nsternie/live_telemetry/board_design/Flight_computer_LT/FlightCompTop.png

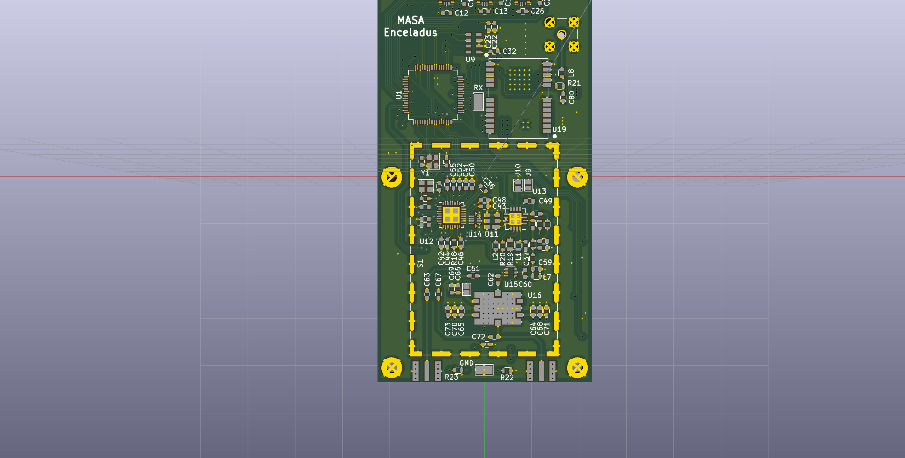
board_design/Flight_computer_LT/FlightCompTop.png
