nsternie/live_telemetry/README.md

# live_telmetry
Home for all data related to the live telemetry project. Firmware, Gui, and board designs,
