nsternie/live_telemetry/scripts/data/2018_03_03_21-58-39/0_plots.pdf

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

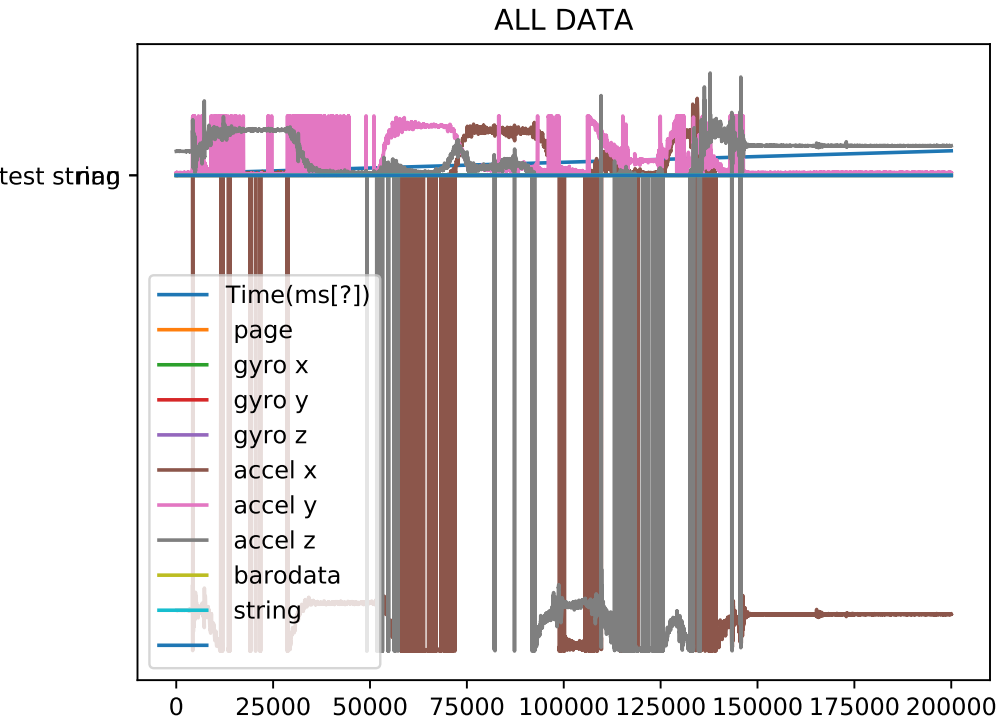
[picture p2: page 1]

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

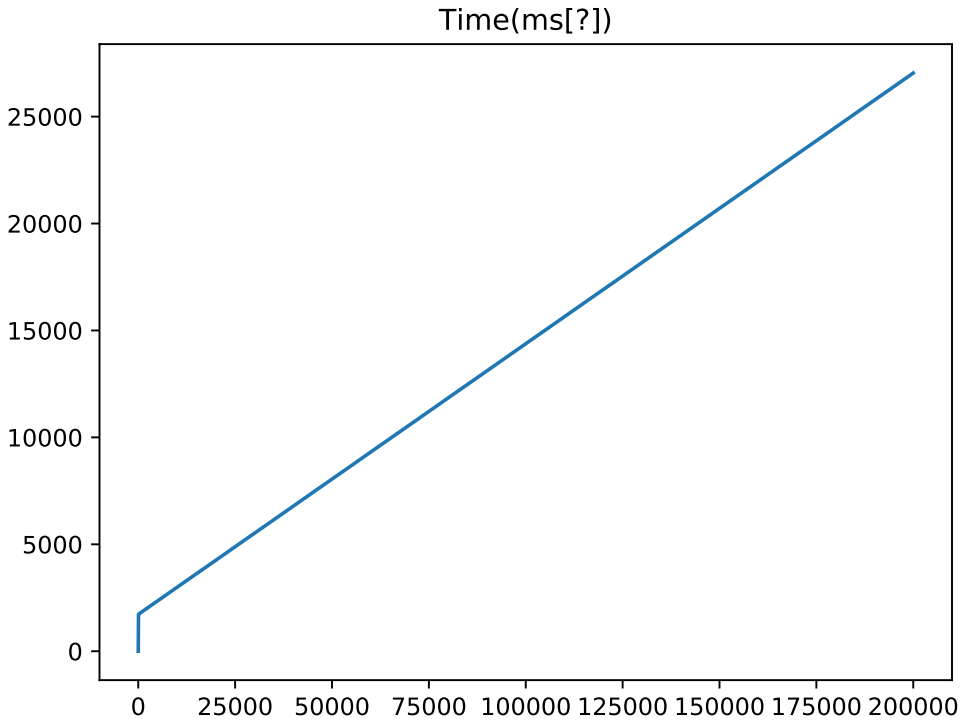
[picture p3: page 2]

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

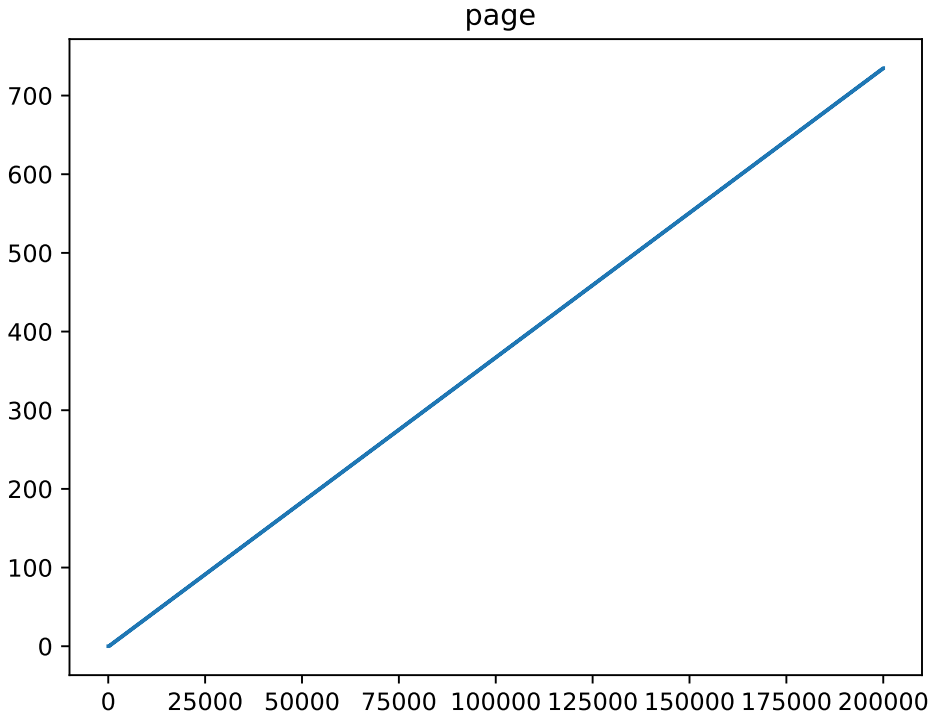
[picture p4: page 3]

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

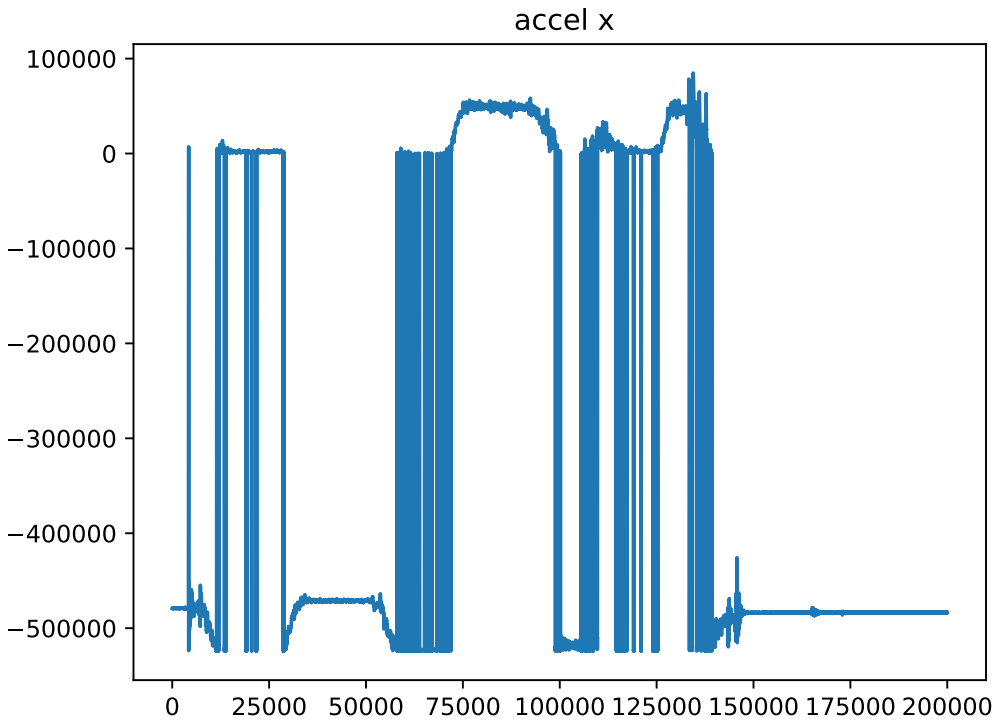
[picture p5: page 7]

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

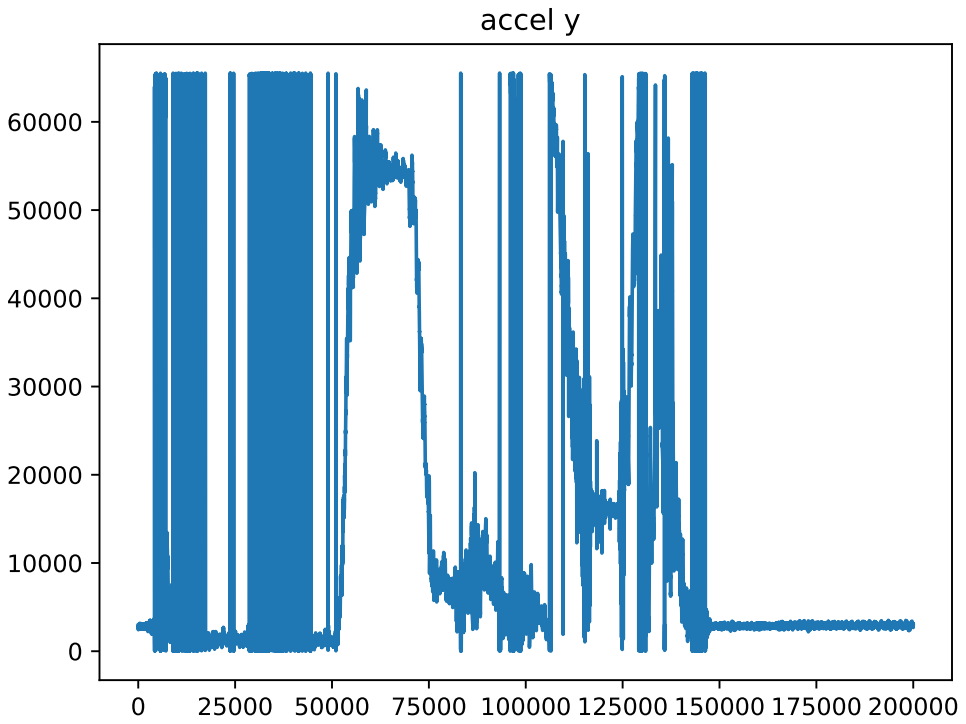
[picture p6: page 8]

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

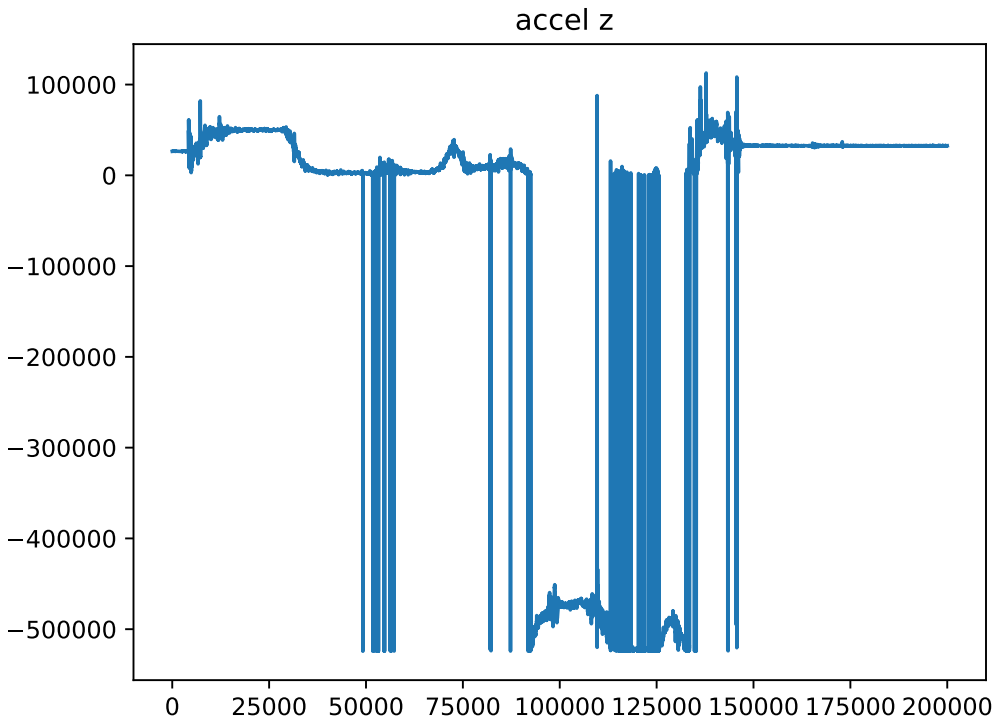
[picture p7: page 9]

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
