nsternie/live_telemetry/scripts/data/2018_03_03_22-02-40/0_plots.pdf

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

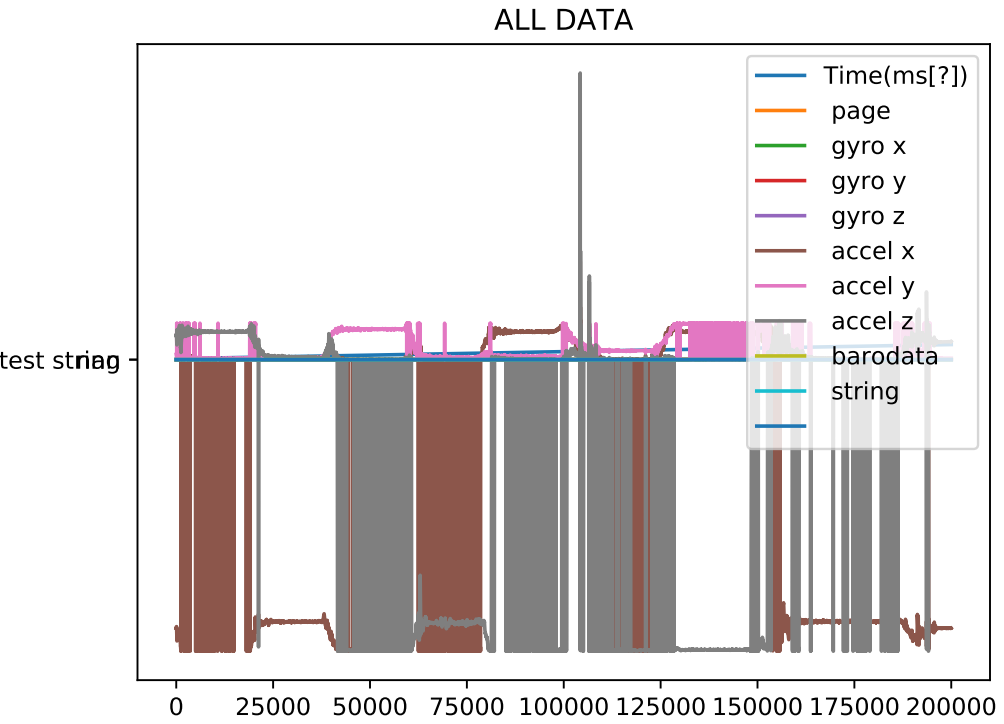
[picture p8: page 1]

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

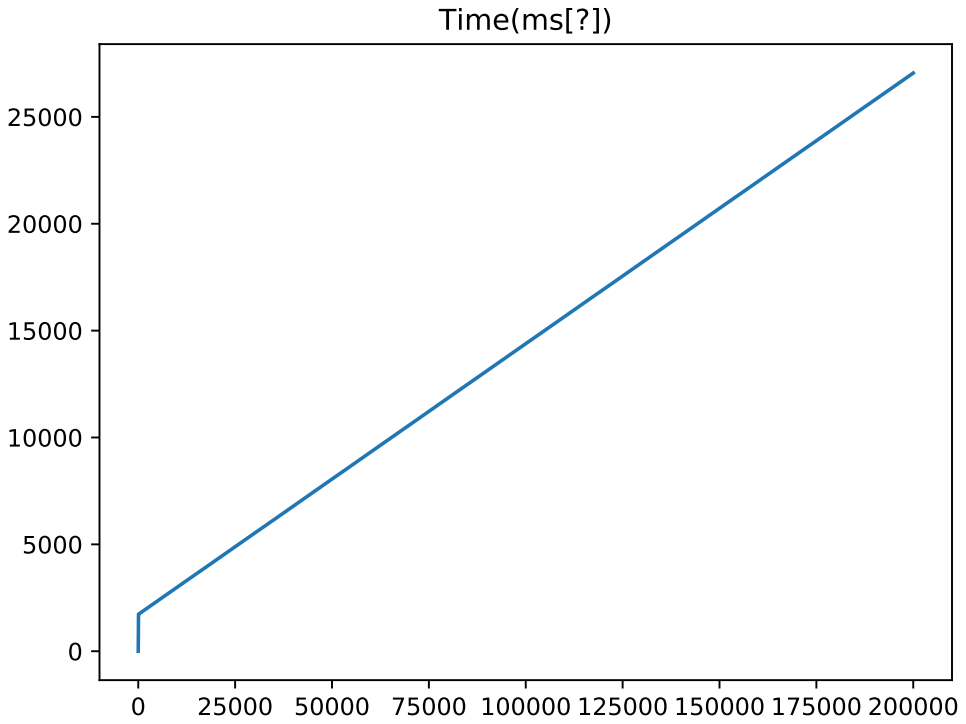
[picture p9: page 2]

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

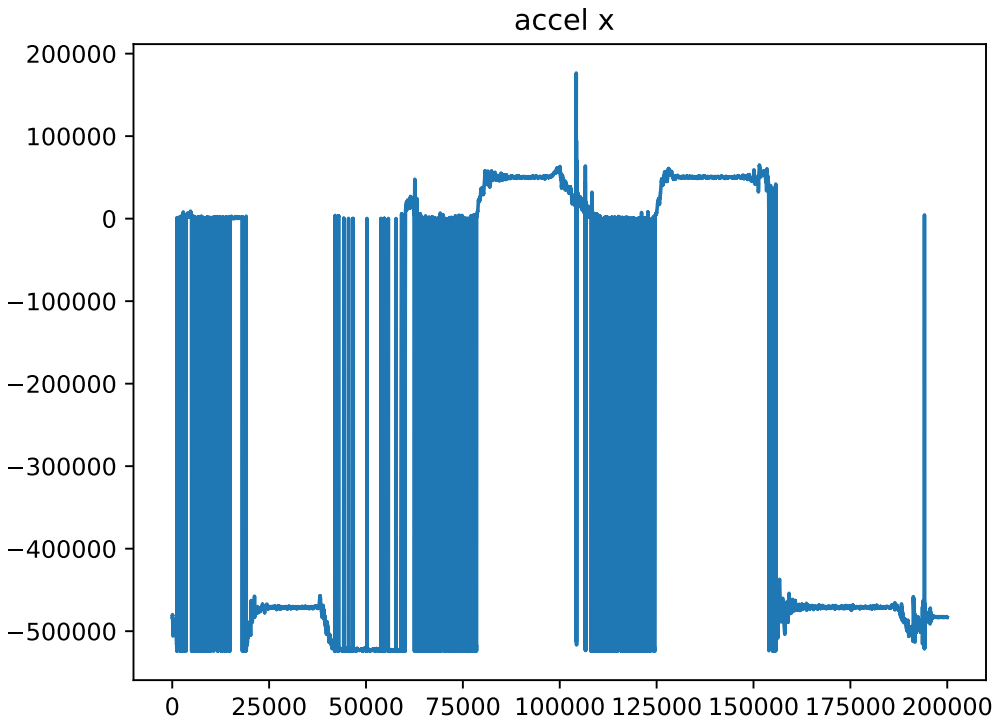
[picture p10: page 7]

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

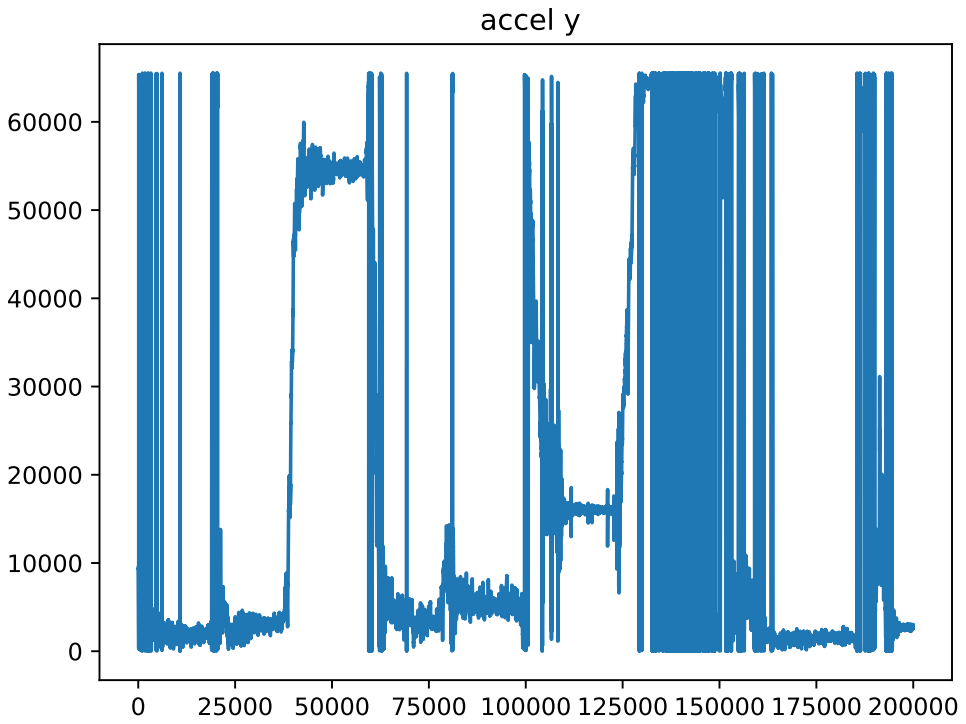
[picture p11: page 8]

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

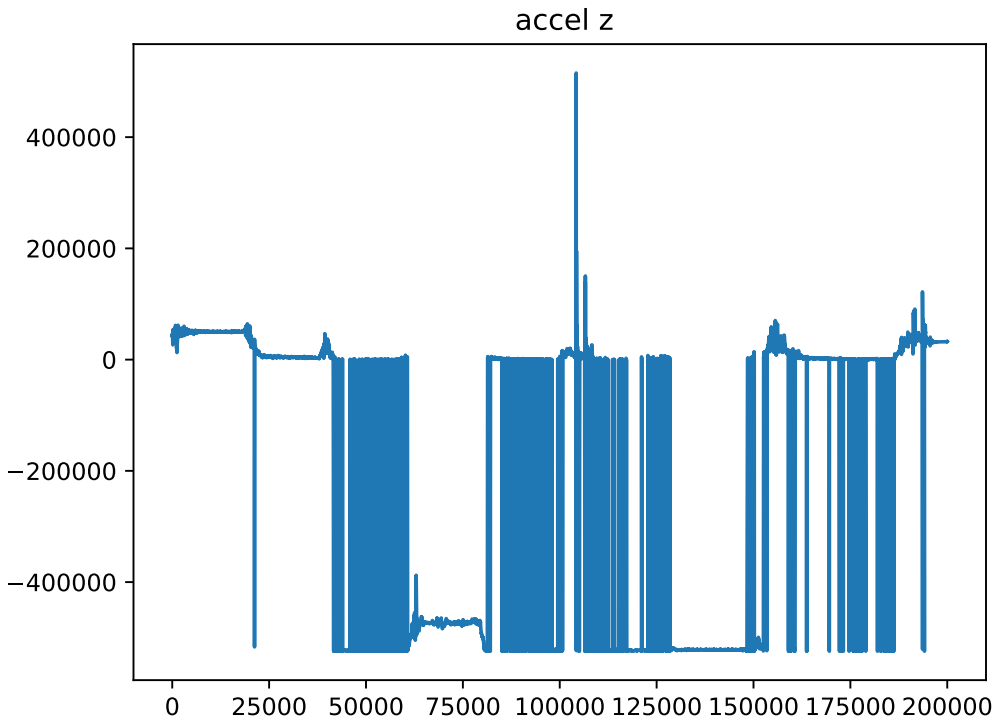
[picture p12: page 9]

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
