nsternie/live_telemetry/scripts/data/2018_03_03_22-16-44/0_plots.pdf

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

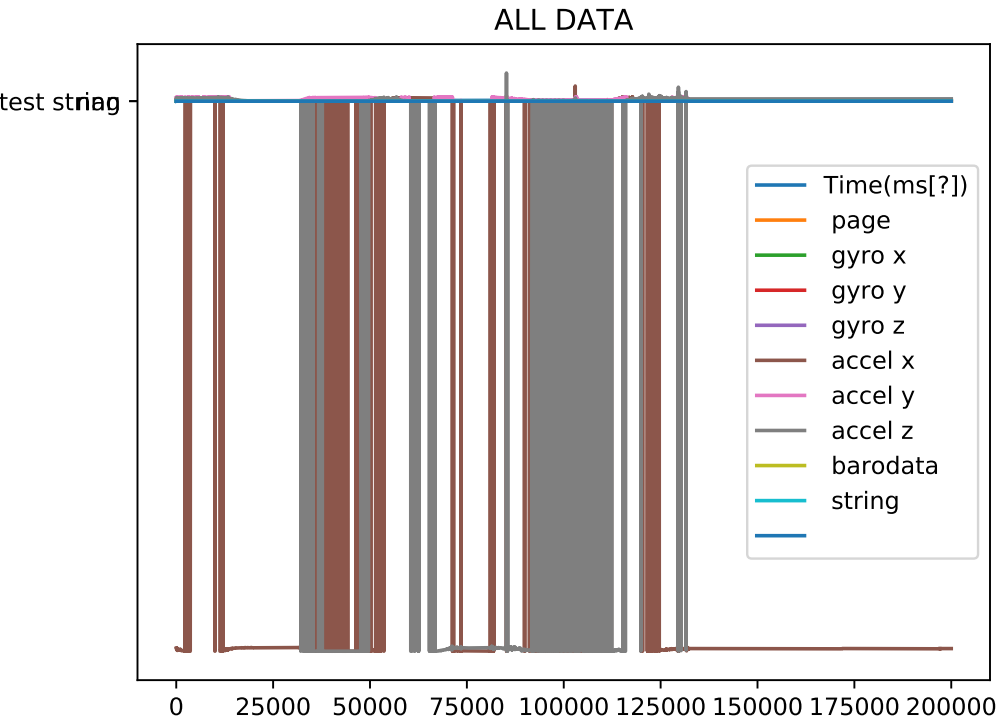
[picture p13: page 1]

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

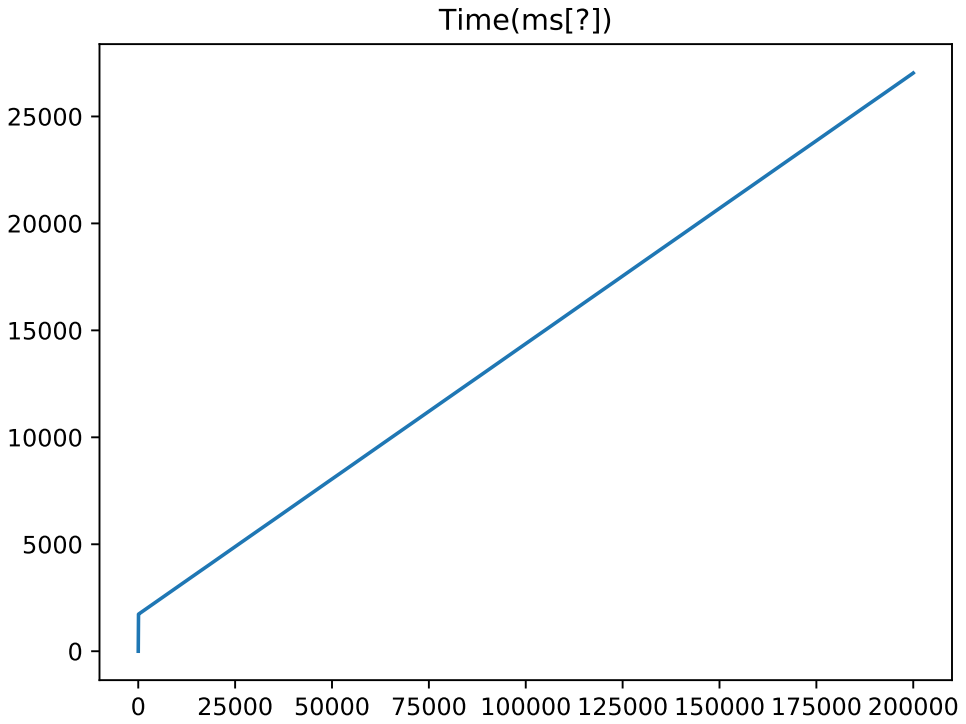
[picture p14: page 2]

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

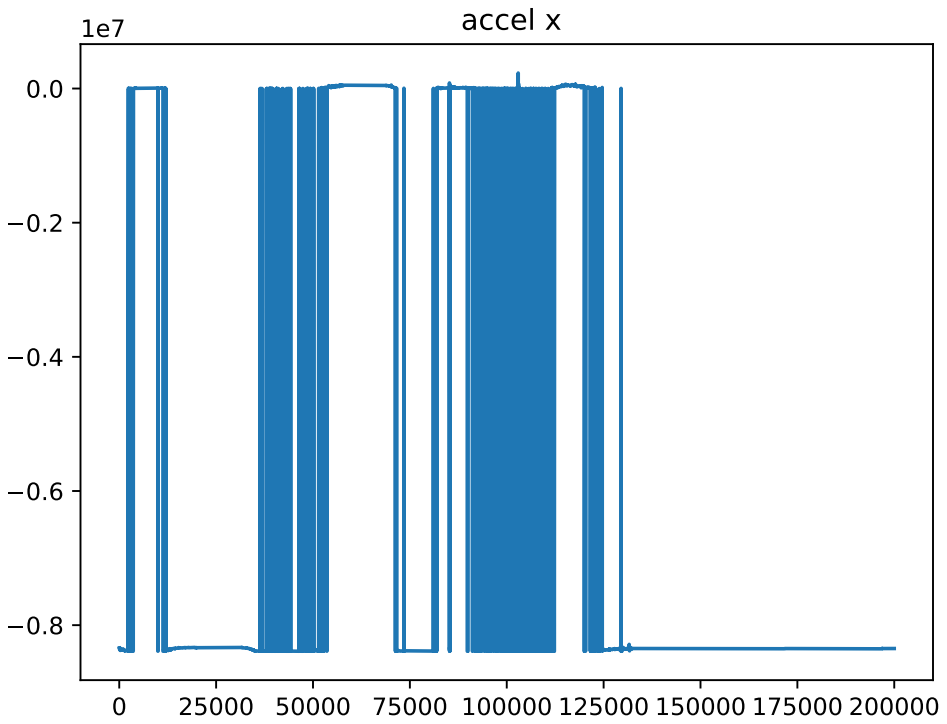
[picture p15: page 7]

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

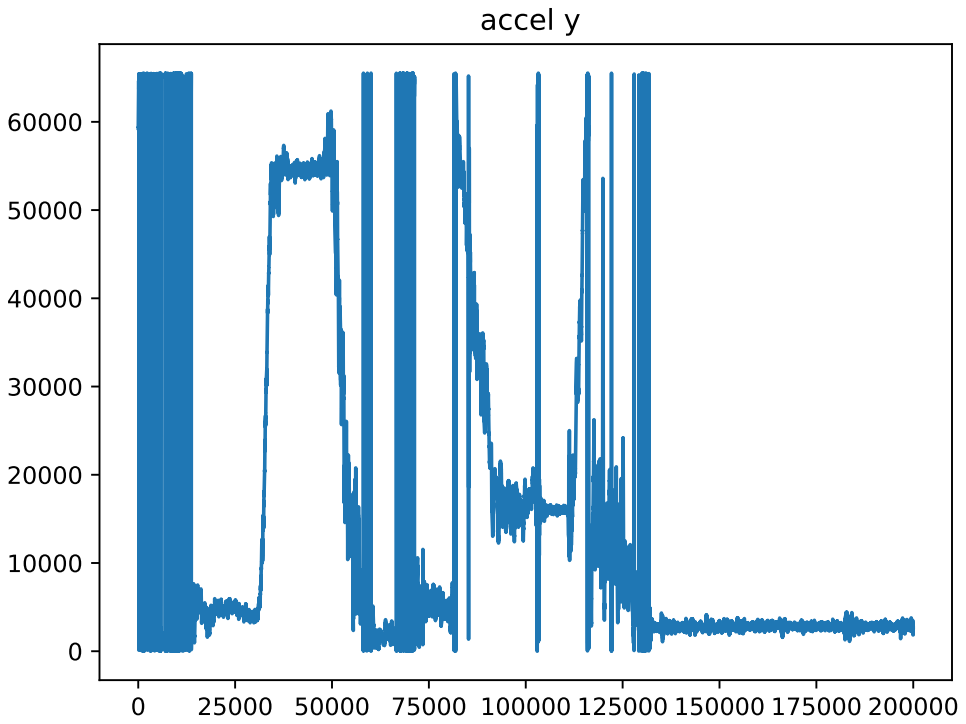
[picture p16: page 8]

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

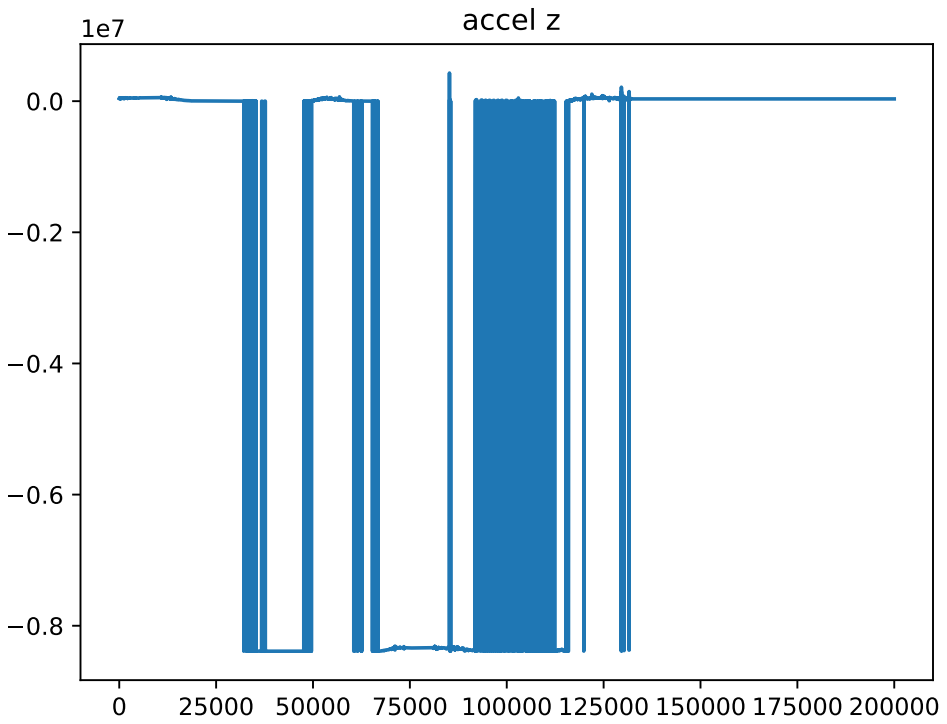
[picture p17: page 9]

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
