nsternie/live_telemetry/scripts/data/2018_03_03_22-34-58/0_plots.pdf

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

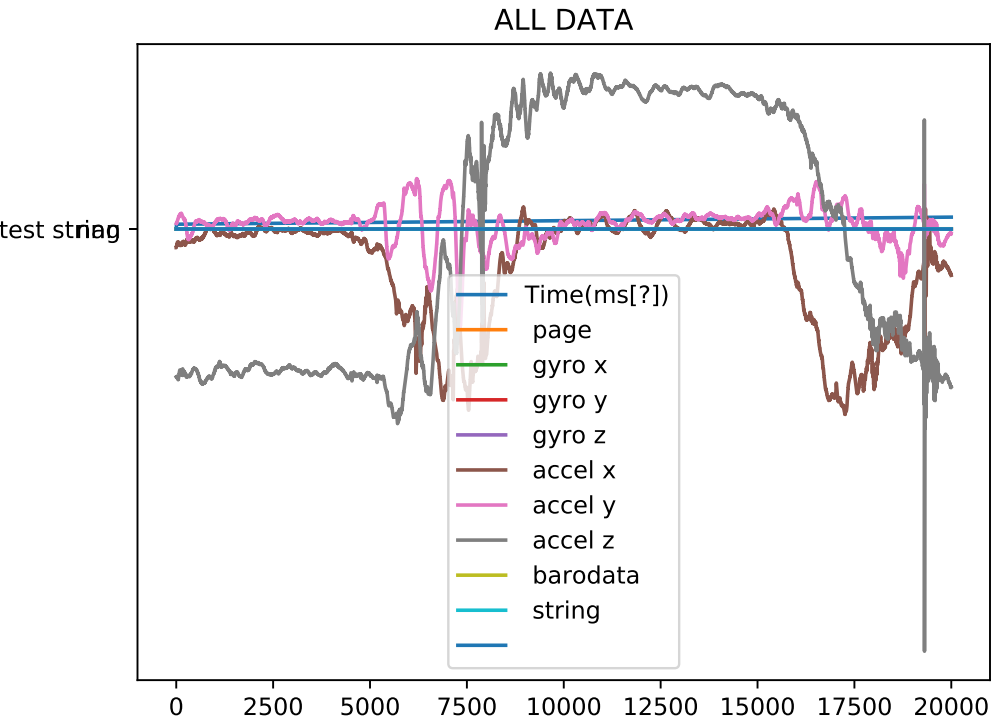
[picture p18: page 1]

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

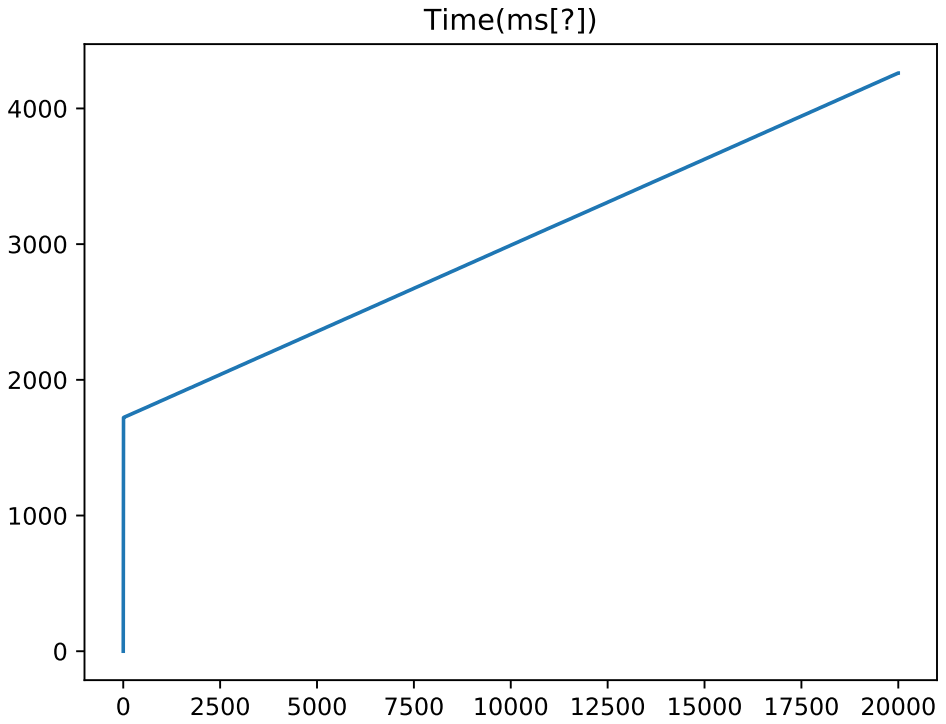
[picture p19: page 2]

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

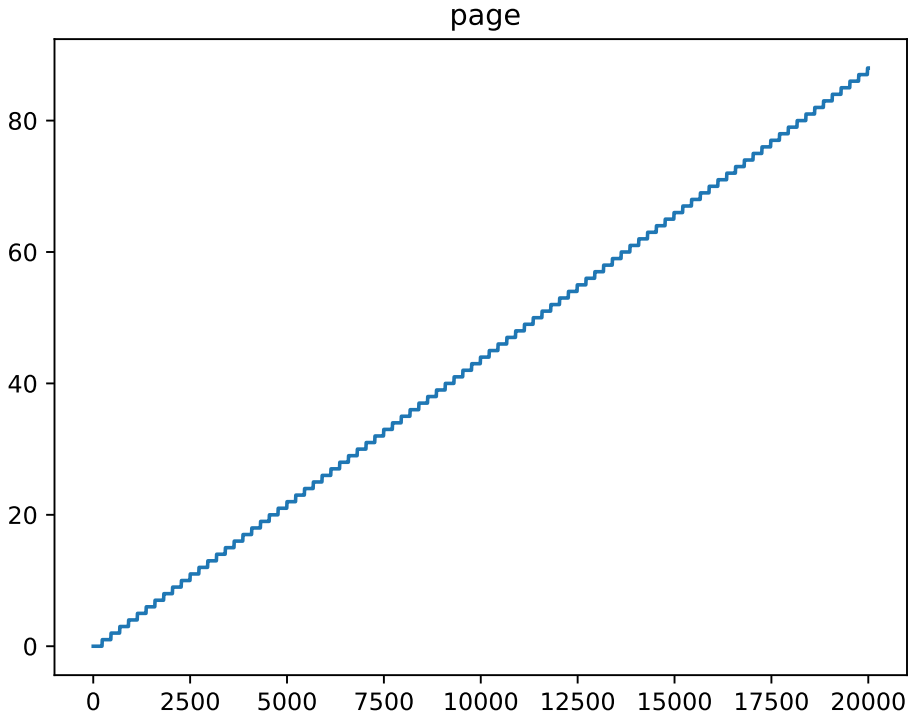
[picture p20: page 3]

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

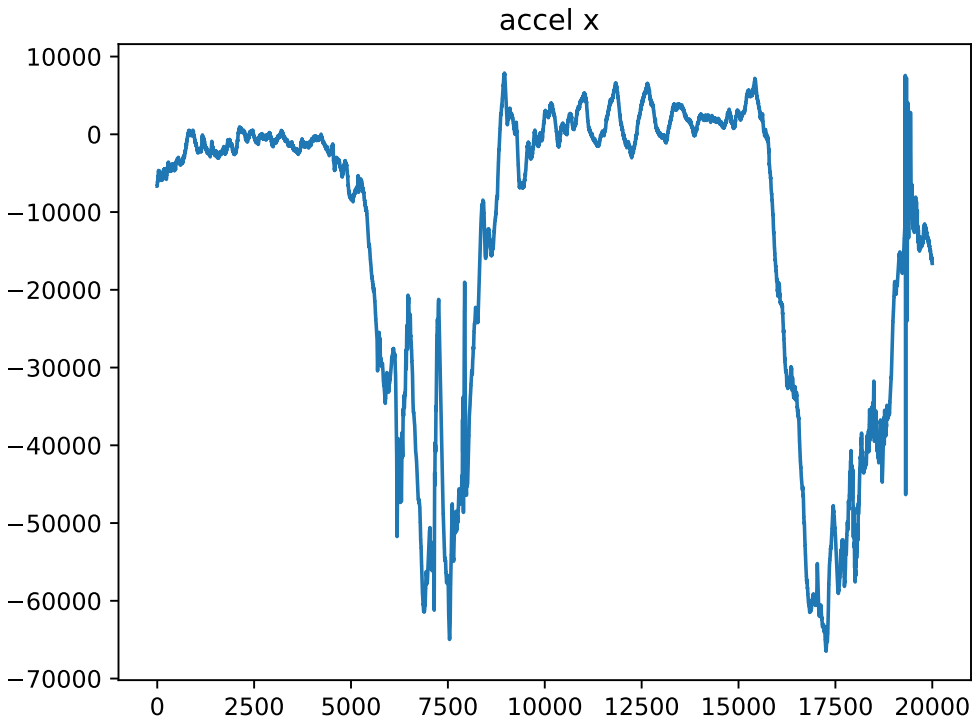
[picture p21: page 7]

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

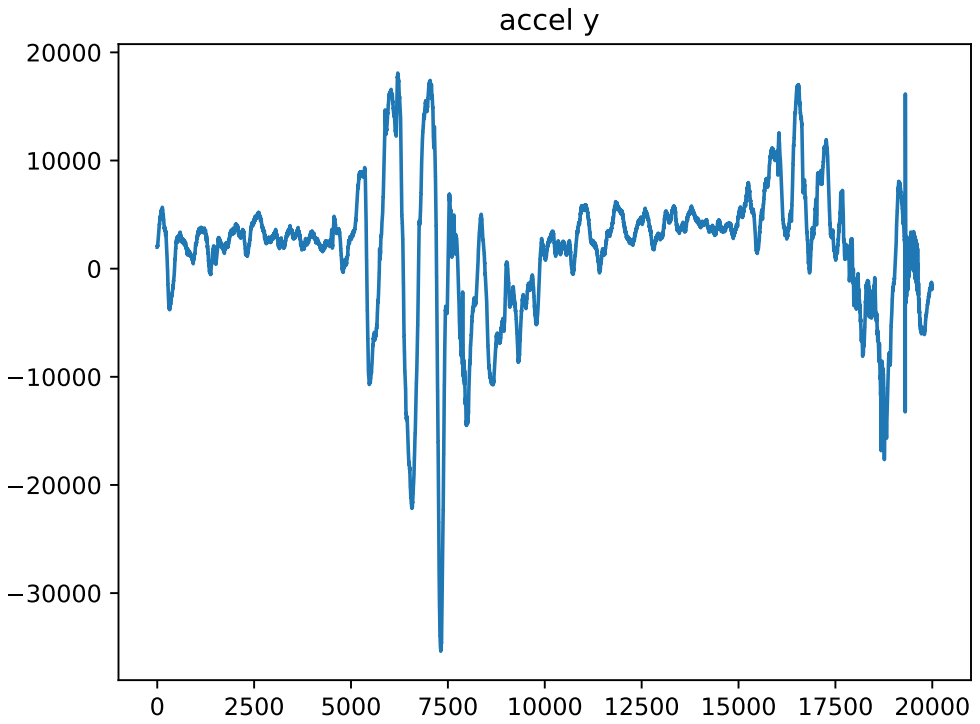
[picture p22: page 8]

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

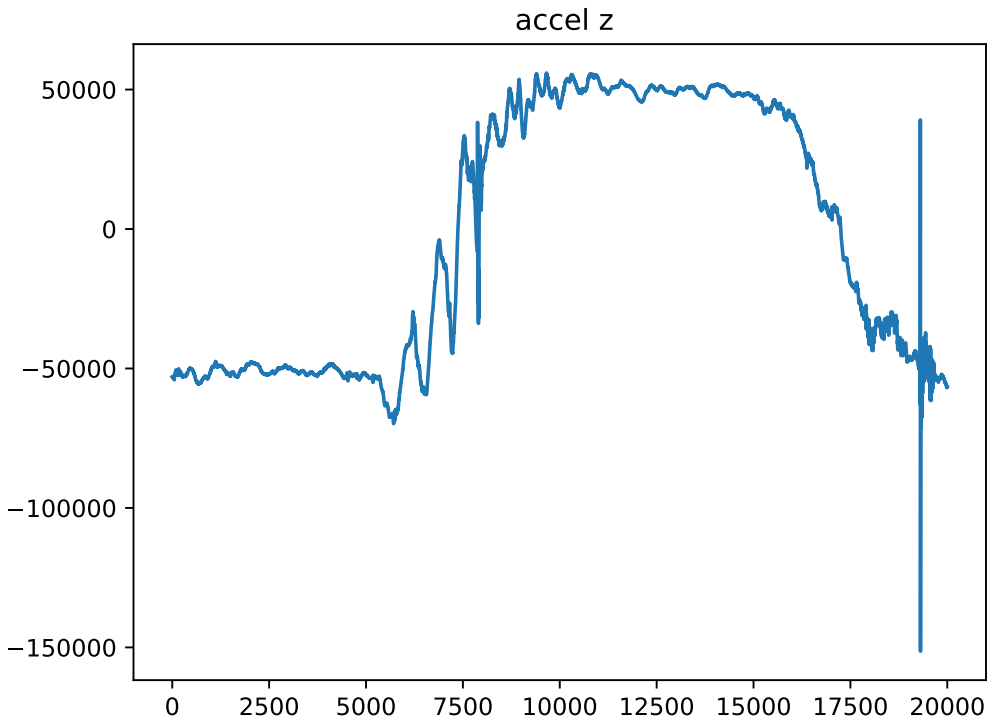
[picture p23: page 9]

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
