nsternie/live_telemetry/board_design/Flight_computer_LT/Flight_computer_LT.kicad_pcb

## KiCad design board_design/Flight_computer_LT/Flight_computer_LT.kicad_pcb (2018-03-17)

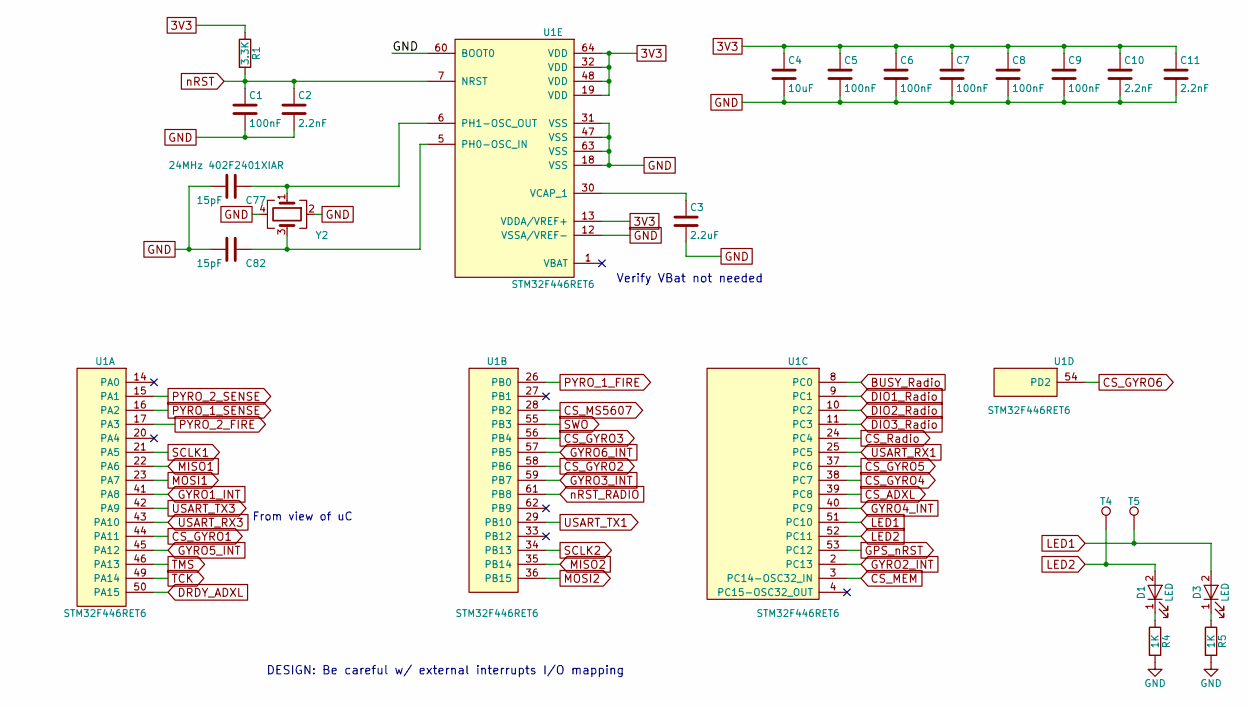
[picture p24: schematic Microcontroller.sch, part in row 1, column 2]

Parts:
C1, C5, C6, C7, C8, C9: 100nF; C_0603
C2, C10, C11: 2.2nF; C_0603
C3: 2.2uF; C_0603
C4: 10uF; C_0603
C77, C82: 15pF; C_0603
D1, D3: LED; LED_0603
R1: 3.3K; R_0603
R4, R5: 1K; R_0603
T4, T5: TP; 0603_TP
U1: STM32F446RET6; LQFP-64_10x10mm_Pitch0.5mm
Y2: 24MHz 402F2401XIAR; Crystal_SMD_2520-4pin_2.5x2.0mm

Connections:
3V3: C4.1, C5.1, C6.1, C7.1, C8.1, C9.1, C10.1, C11.1, R1.1, U1.13 (VDDA/VREF+), U1.19 (VDD), U1.32 (VDD), U1.48 (VDD), U1.64 (VDD); also elsewhere on the board
BUSY_Radio: U1.8 (PC0); also elsewhere on the board
CS_ADXL: U1.39 (PC8); also elsewhere on the board
CS_GYRO1: U1.44 (PA11); also elsewhere on the board
CS_GYRO2: U1.58 (PB6); also elsewhere on the board
CS_GYRO3: U1.56 (PB4); also elsewhere on the board
CS_GYRO4: U1.38 (PC7); also elsewhere on the board
CS_GYRO5: U1.37 (PC6); also elsewhere on the board
CS_GYRO6: U1.54 (PD2); also elsewhere on the board
CS_MEM: U1.3 (PC14-OSC32_IN); also elsewhere on the board
CS_MS5607: U1.28 (PB2); also elsewhere on the board
CS_Radio: U1.24 (PC4); also elsewhere on the board
DIO1_Radio: U1.9 (PC1); also elsewhere on the board
DIO2_Radio: U1.10 (PC2); also elsewhere on the board
DIO3_Radio: U1.11 (PC3); also elsewhere on the board
DRDY_ADXL: U1.50 (PA15); also elsewhere on the board
GND: C1.2, C2.2, C3.2, C4.2, C5.2, C6.2, C7.2, C8.2, C9.2, C10.2, C11.2, C77.2, C82.2, R4.2, R5.2, U1.12 (VSSA/VREF-), U1.18 (VSS), U1.31 (VSS), U1.47 (VSS), U1.60 (BOOT0), U1.63 (VSS), Y2.2, Y2.4; also elsewhere on the board
GPS_nRST: U1.53 (PC12); also elsewhere on the board
GYRO1_INT: U1.41 (PA8); also elsewhere on the board
GYRO2_INT: U1.2 (PC13); also elsewhere on the board
GYRO3_INT: U1.59 (PB7); also elsewhere on the board
GYRO4_INT: U1.40 (PC9); also elsewhere on the board
GYRO5_INT: U1.45 (PA12); also elsewhere on the board
GYRO6_INT: U1.57 (PB5); also elsewhere on the board
LED1: D3.2 (A), T5.1, U1.51 (PC10)
LED2: D1.2 (A), T4.1, U1.52 (PC11)
MISO1: U1.22 (PA6); also elsewhere on the board
MISO2: U1.35 (PB14); also elsewhere on the board
MOSI1: U1.23 (PA7); also elsewhere on the board
MOSI2: U1.36 (PB15); also elsewhere on the board
unnamed: C3.1, U1.30 (VCAP_1)
unnamed: C77.1, U1.6 (PH1-OSC_OUT), Y2.1
unnamed: C82.1, U1.5 (PH0-OSC_IN), Y2.3
unnamed: D1.1 (K), R4.1
unnamed: D3.1 (K), R5.1
PYRO_1_FIRE: U1.26 (PB0); also elsewhere on the board
PYRO_1_SENSE: U1.16 (PA2); also elsewhere on the board
PYRO_2_FIRE: U1.17 (PA3); also elsewhere on the board
PYRO_2_SENSE: U1.15 (PA1); also elsewhere on the board
SCLK1: U1.21 (PA5); also elsewhere on the board
SCLK2: U1.34 (PB13); also elsewhere on the board
SWO: U1.55 (PB3); also elsewhere on the board
TCK: U1.49 (PA14); also elsewhere on the board
TMS: U1.46 (PA13); also elsewhere on the board
USART_RX1: U1.25 (PC5); also elsewhere on the board
USART_RX3: U1.43 (PA10); also elsewhere on the board
USART_TX1: U1.29 (PB10); also elsewhere on the board
USART_TX3: U1.42 (PA9); also elsewhere on the board
nRST: C1.1, C2.1, R1.2, U1.7 (NRST); also elsewhere on the board
nRST_RADIO: U1.61 (PB8); also elsewhere on the board

Notes on the sheet:
Verify VBat not needed
DESIGN: Be careful w/ external interrupts I/O mapping
From view of uC

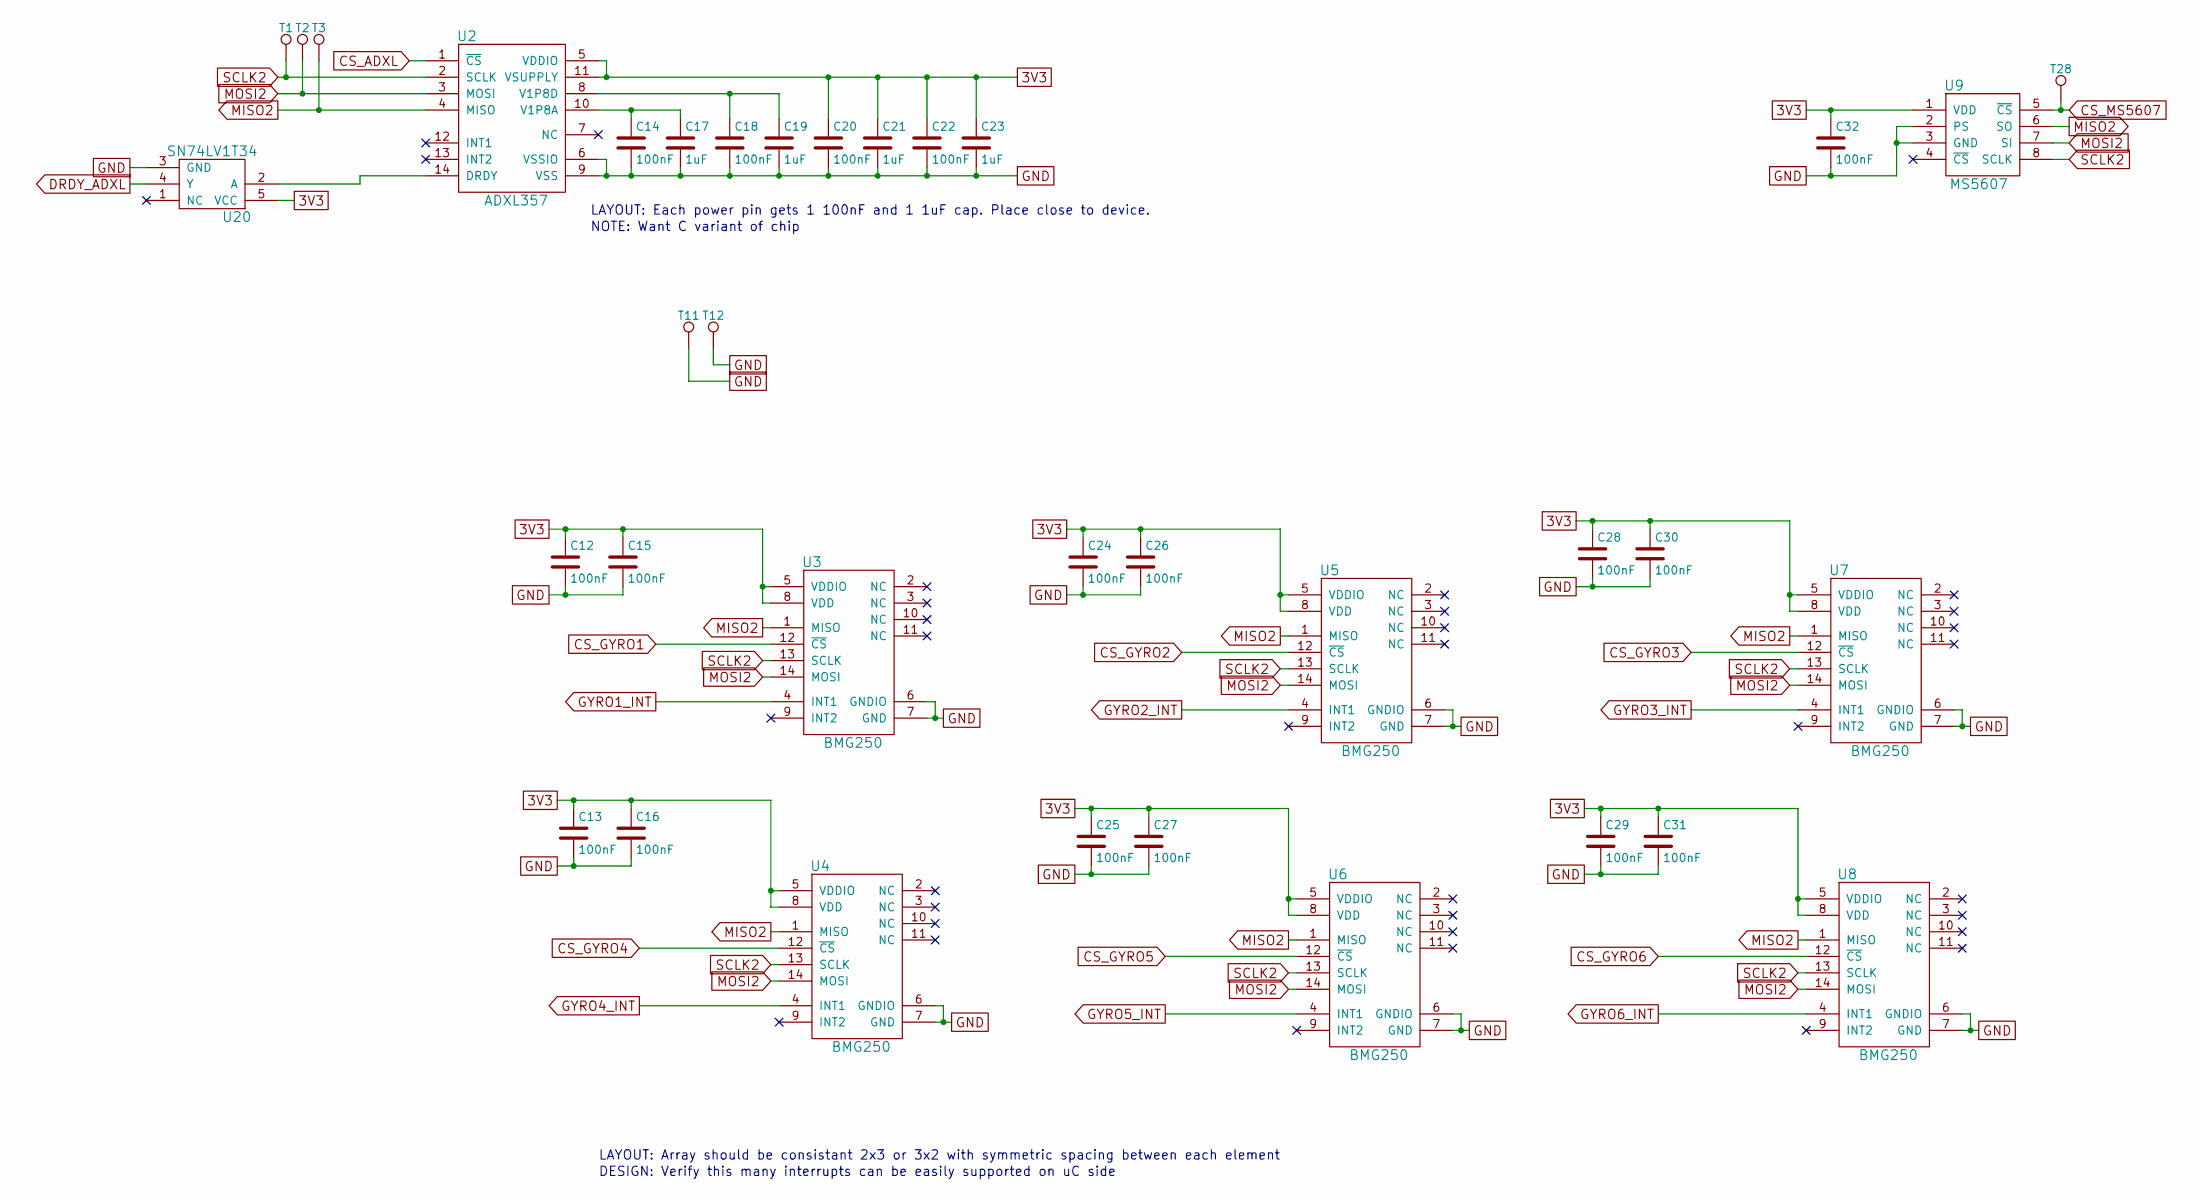
[picture p25: schematic Sensors.sch]

Parts:
C12, C13, C14, C15, C16, C18, C20, C22, C24, C25, C26, C27, C28, C29, C30, C31, C32: 100nF; C_0603
C17, C19, C21, C23: 1uF; C_0603
T1, T2, T3, T11, T12: TP; 0603_TP
T28: TEST_1P; PAD_TP_1mm
U2: ADXL357
U3, U4, U5, U6, U7, U8: BMG250; Bosch_LGA-14_3x2.5mm_Pitch0.5mm
U9: MS5607
U20: SN74LV1T34; SOT-23-5

Connections:
3V3: C12.1, C13.1, C15.1, C16.1, C20.1, C21.1, C22.1, C23.1, C24.1, C25.1, C26.1, C27.1, C28.1, C29.1, C30.1, C31.1, C32.1, U2.5 (VDDIO), U2.11 (VSUPPLY), U3.5 (VDDIO), U3.8 (VDD), U4.5 (VDDIO), U4.8 (VDD), U5.5 (VDDIO), U5.8 (VDD), U6.5 (VDDIO), U6.8 (VDD), U7.5 (VDDIO), U7.8 (VDD), U8.5 (VDDIO), U8.8 (VDD), U9.1 (VDD), U20.5 (VCC); also elsewhere on the board
CS_ADXL: U2.1 (~CS); also elsewhere on the board
CS_GYRO1: U3.12 (~CS); also elsewhere on the board
CS_GYRO2: U5.12 (~CS); also elsewhere on the board
CS_GYRO3: U7.12 (~CS); also elsewhere on the board
CS_GYRO4: U4.12 (~CS); also elsewhere on the board
CS_GYRO5: U6.12 (~CS); also elsewhere on the board
CS_GYRO6: U8.12 (~CS); also elsewhere on the board
CS_MS5607: T28.1, U9.5 (~CS); also elsewhere on the board
DRDY_ADXL: U20.4 (Y); also elsewhere on the board
GND: C12.2, C13.2, C14.2, C15.2, C16.2, C17.2, C18.2, C19.2, C20.2, C21.2, C22.2, C23.2, C24.2, C25.2, C26.2, C27.2, C28.2, C29.2, C30.2, C31.2, C32.2, T11.1, T12.1, U2.6 (VSSIO), U2.9 (VSS), U3.6 (GNDIO), U3.7 (GND), U4.6 (GNDIO), U4.7 (GND), U5.6 (GNDIO), U5.7 (GND), U6.6 (GNDIO), U6.7 (GND), U7.6 (GNDIO), U7.7 (GND), U8.6 (GNDIO), U8.7 (GND), U9.2 (PS), U9.3 (GND), U20.3 (GND); also elsewhere on the board
GYRO1_INT: U3.4 (INT1); also elsewhere on the board
GYRO2_INT: U5.4 (INT1); also elsewhere on the board
GYRO3_INT: U7.4 (INT1); also elsewhere on the board
GYRO4_INT: U4.4 (INT1); also elsewhere on the board
GYRO5_INT: U6.4 (INT1); also elsewhere on the board
GYRO6_INT: U8.4 (INT1); also elsewhere on the board
MISO2: T3.1, U2.4 (MISO), U3.1 (MISO), U4.1 (MISO), U5.1 (MISO), U6.1 (MISO), U7.1 (MISO), U8.1 (MISO), U9.6 (SO); also elsewhere on the board
MOSI2: T2.1, U2.3 (MOSI), U3.14 (MOSI), U4.14 (MOSI), U5.14 (MOSI), U6.14 (MOSI), U7.14 (MOSI), U8.14 (MOSI), U9.7 (SI); also elsewhere on the board
unnamed: C14.1, C17.1, U2.10 (V1P8A)
unnamed: C18.1, C19.1, U2.8 (V1P8D)
unnamed: U2.14 (DRDY), U20.2 (A)
SCLK2: T1.1, U2.2 (SCLK), U3.13 (SCLK), U4.13 (SCLK), U5.13 (SCLK), U6.13 (SCLK), U7.13 (SCLK), U8.13 (SCLK), U9.8 (SCLK); also elsewhere on the board

Notes on the sheet:
LAYOUT: Each power pin gets 1 100nF and 1 1uF cap. Place close to device.
LAYOUT: Array should be consistant 2x3 or 3x2 with symmetric spacing between each element
DESIGN: Verify this many interrupts can be easily supported on uC side
NOTE: Want C variant of chip

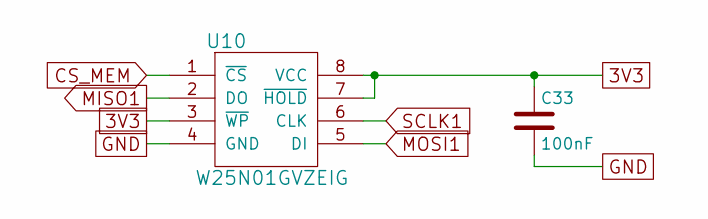
[picture p26: schematic Memory.sch]

Parts:
C33: 100nF; C_0603
U10: W25N01GVZEIG; 8-WSON_8x6

Connections:
3V3: C33.1, U10.3 (~WP), U10.7 (~HOLD), U10.8 (VCC); also elsewhere on the board
CS_MEM: U10.1 (~CS); also elsewhere on the board
GND: C33.2, U10.4 (GND); also elsewhere on the board
MISO1: U10.2 (DO); also elsewhere on the board
MOSI1: U10.5 (DI); also elsewhere on the board
SCLK1: U10.6 (CLK); also elsewhere on the board

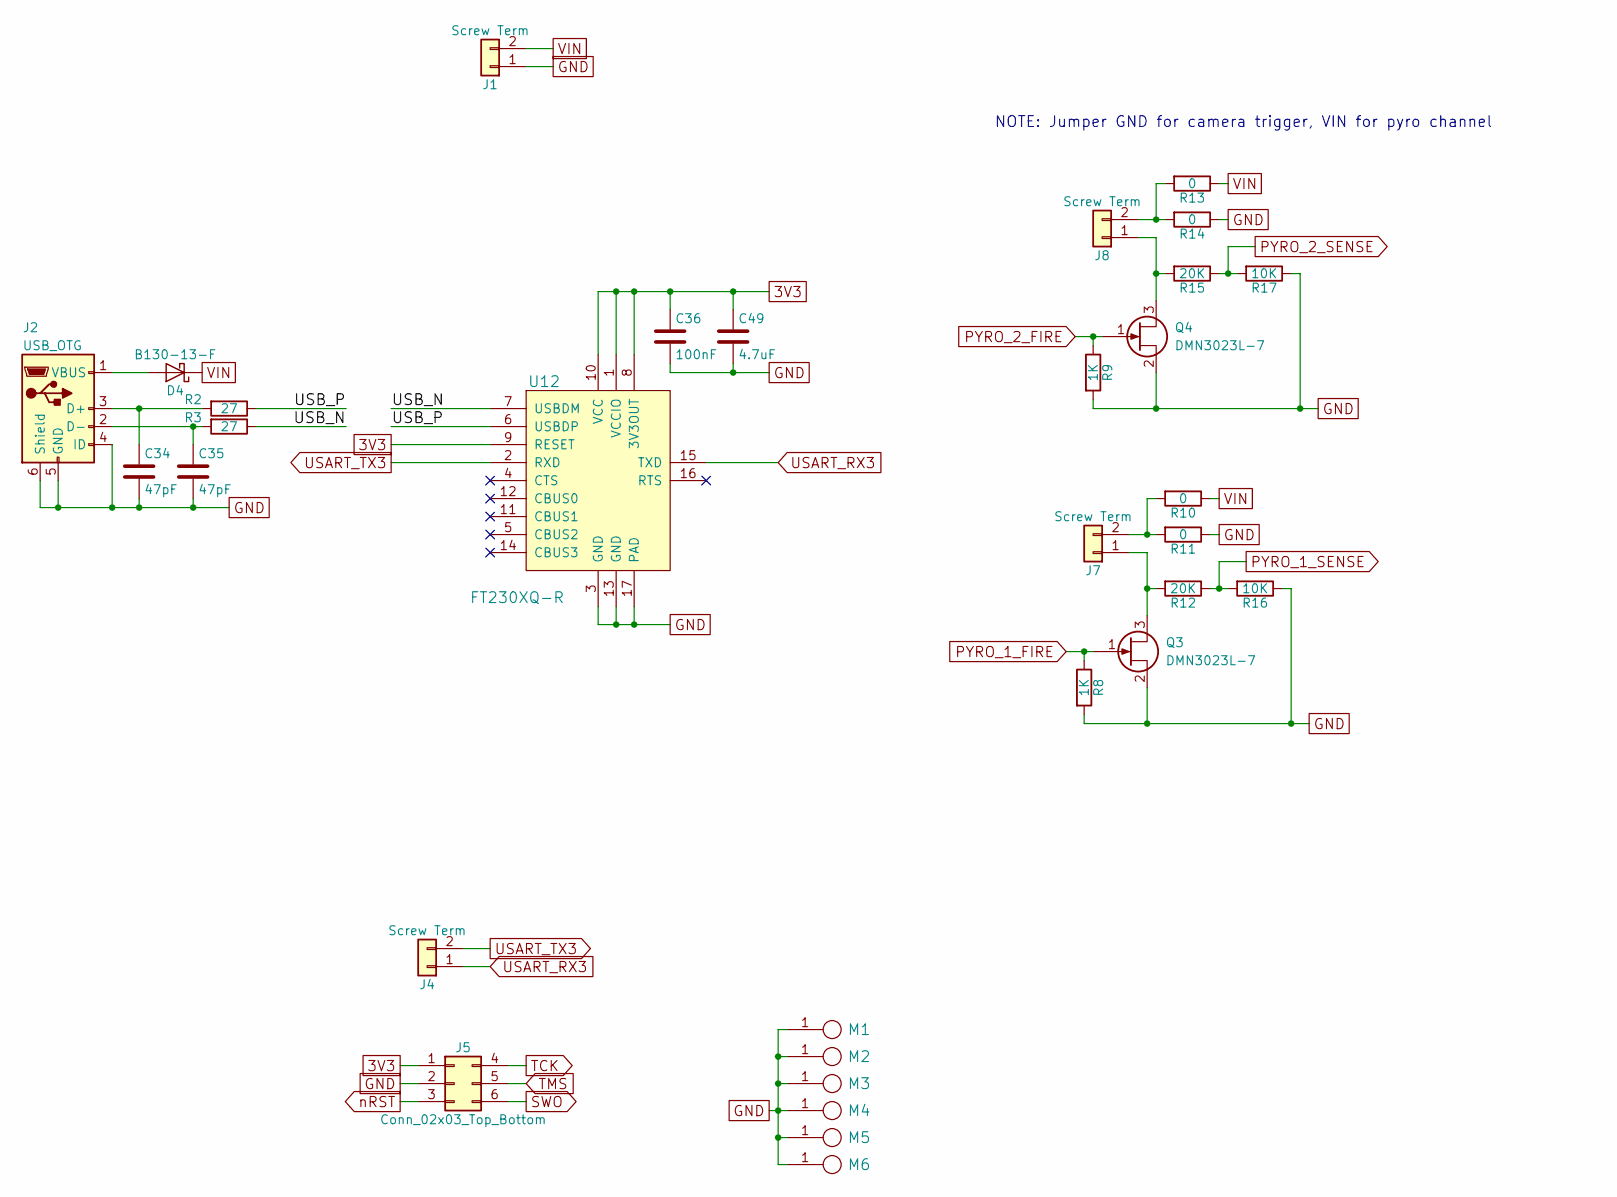
[picture p27: schematic Connectors.sch]

Parts:
C34, C35: 47pF; C_0603
C36: 100nF; C_0603
C49: 4.7uF; C_0603
D4: B130-13-F; D_SMA
J1, J4, J7, J8: Screw Term; TerminalBlock_bornier-2_P5.08mm
J2: USB_OTG; USB_Micro-B
J5: Conn_02x03_Top_Bottom; 2X6_SMA_HEADER_2.54mm
M1, M2, M3, M4, M5, M6: M2.5; MountingHole_2.2mm_M2_Pad
Q3, Q4: DMN3023L-7; SOT-23
R2, R3: 27; R_0603
R8, R9: 1K; R_0603
R10, R11, R13, R14: 0; R_0603
R12, R15: 20K; R_0603
R16, R17: 10K; R_0603
U12: FT230XQ-R; WQFN-16-1EP_4x4mm; MPN FT230XQ-R; Digi-Key_PN 768-1130-1-ND

Connections:
3V3: C36.1, C49.1, J5.1, U12.1 (VCCIO), U12.8 (3V3OUT), U12.9 (RESET), U12.10 (VCC); also elsewhere on the board
/Connectors/USB_N: R3.1, U12.7 (USBDM)
/Connectors/USB_P: R2.1, U12.6 (USBDP)
GND: C34.2, C35.2, C36.2, C49.2, J1.1, J2.4 (ID), J2.5 (GND), J2.6 (Shield), J5.2, M1.1, M2.1, M3.1, M4.1, M5.1, M6.1, Q3.2 (S), Q4.2 (S), R8.2, R9.2, R11.1, R14.1, R16.1, R17.1, U12.3 (GND), U12.13 (GND), U12.17 (PAD); also elsewhere on the board
unnamed: C34.1, J2.3 (D+), R2.2
unnamed: C35.1, J2.2 (D-), R3.2
unnamed: D4.2 (A), J2.1 (VBUS)
unnamed: J7.1, Q3.3 (D), R12.2
unnamed: J7.2, R10.2, R11.2
unnamed: J8.1, Q4.3 (D), R15.2
unnamed: J8.2, R13.2, R14.2
PYRO_1_FIRE: Q3.1 (G), R8.1; also elsewhere on the board
PYRO_1_SENSE: R12.1, R16.2; also elsewhere on the board
PYRO_2_FIRE: Q4.1 (G), R9.1; also elsewhere on the board
PYRO_2_SENSE: R15.1, R17.2; also elsewhere on the board
SWO: J5.6; also elsewhere on the board
TCK: J5.4; also elsewhere on the board
TMS: J5.5; also elsewhere on the board
USART_RX3: J4.1, U12.15 (TXD); also elsewhere on the board
USART_TX3: J4.2, U12.2 (RXD); also elsewhere on the board
VIN: D4.1 (K), J1.2, R10.1, R13.1; also elsewhere on the board
nRST: J5.3; also elsewhere on the board

Notes on the sheet:
NOTE: Jumper GND for camera trigger, VIN for pyro channel

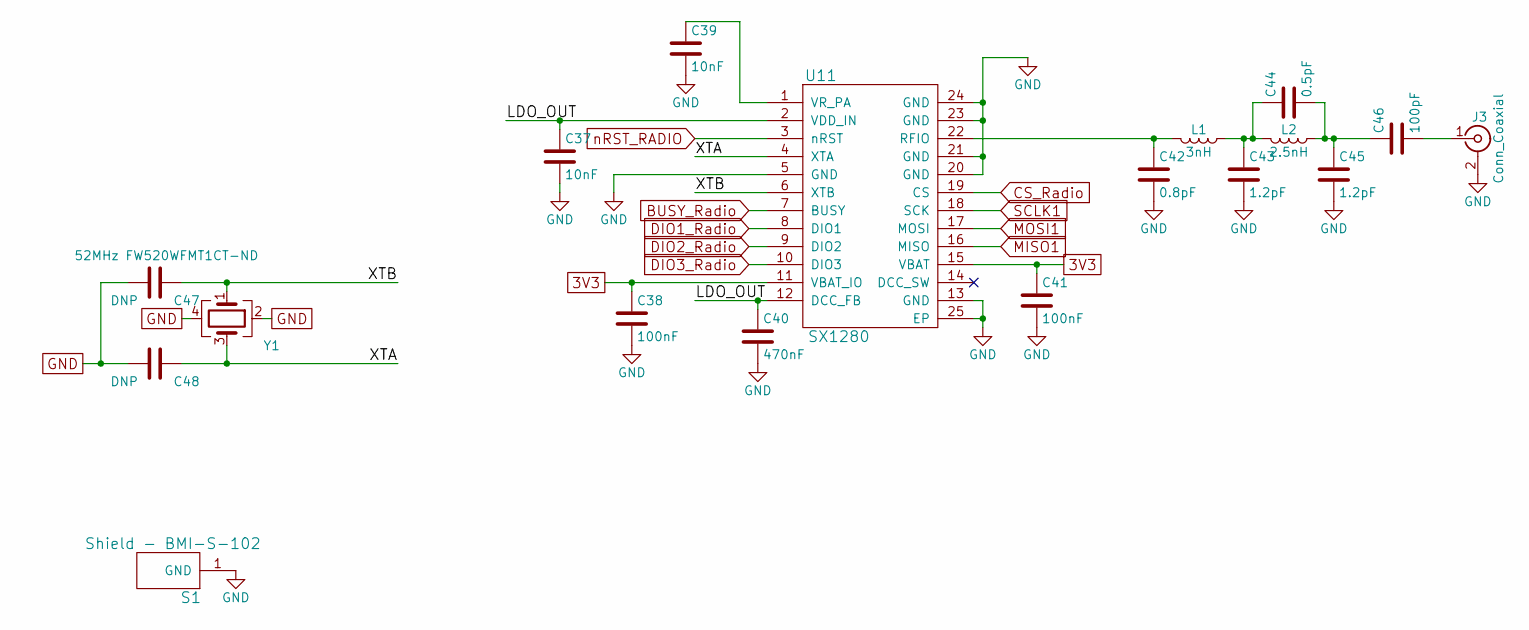
[picture p28: schematic Radio.sch]

Parts:
C37, C39: 10nF; 0603
C38, C41: 100nF; 0603
C40: 470nF; 0603
C42: 0.8pF; C_0402_NoSilk
C43, C45: 1.2pF; C_0402_NoSilk
C44: 0.5pF; C_0402_NoSilk
C46: 100pF; C_0402_NoSilk
C47, C48: DNP; C_0603
J3: Conn_Coaxial; EBAY_SMA
L1: 3nH; C_0402
L2: 2.5nH; C_0402
S1: Shield - BMI-S-102; Laird_Technologies_BMI-S-102_16.50x16.50mm
U11: SX1280; QFN-24-1EP_4x4mm_Pitch0.5mm
Y1: 52MHz FW520WFMT1CT-ND; Crystal_SMD_2016-4pin_2.0x1.6mm

Connections:
3V3: C38.1, C41.1, U11.11 (VBAT_IO), U11.15 (VBAT); also elsewhere on the board
/Radio/LDO_OUT: C37.1, C40.1, U11.2 (VDD_IN), U11.12 (DCC_FB)
/Radio/XTA: C48.1, U11.4 (XTA), Y1.3
/Radio/XTB: C47.1, U11.6 (XTB), Y1.1
BUSY_Radio: U11.7 (BUSY); also elsewhere on the board
CS_Radio: U11.19 (CS); also elsewhere on the board
DIO1_Radio: U11.8 (DIO1); also elsewhere on the board
DIO2_Radio: U11.9 (DIO2); also elsewhere on the board
DIO3_Radio: U11.10 (DIO3); also elsewhere on the board
GND: C37.2, C38.2, C39.2, C40.2, C41.2, C42.2, C43.2, C45.2, C47.2, C48.2, J3.2 (Ext), S1.1, U11.5 (GND), U11.13 (GND), U11.20 (GND), U11.21 (GND), U11.23 (GND), U11.24 (GND), U11.25 (EP), Y1.2, Y1.4; also elsewhere on the board
MISO1: U11.16 (MISO); also elsewhere on the board
MOSI1: U11.17 (MOSI); also elsewhere on the board
unnamed: C39.1, U11.1 (VR_PA)
unnamed: C42.1, L1.2, U11.22 (RFIO)
unnamed: C43.1, C44.1, L1.1, L2.2
unnamed: C44.2, C45.1, C46.1, L2.1
unnamed: C46.2, J3.1 (In)
SCLK1: U11.18 (SCK); also elsewhere on the board
nRST_RADIO: U11.3 (nRST); also elsewhere on the board

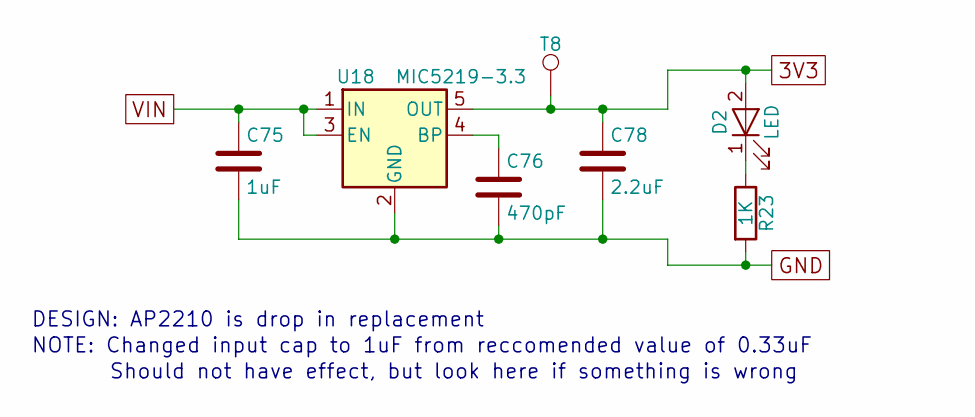
[picture p29: schematic Power.sch]

Parts:
C75: 1uF; C_0603
C76: 470pF; C_0603
C78: 2.2uF; C_0603
D2: LED; LED_0603
R23: 1K; R_0603
T8: TP; 0603_TP
U18: MIC5219-3.3; SOT-23-5

Connections:
3V3: C78.1, D2.2 (A), T8.1, U18.5 (OUT); also elsewhere on the board
GND: C75.2, C76.2, C78.2, R23.2, U18.2 (GND); also elsewhere on the board
unnamed: C76.1, U18.4 (BP)
unnamed: D2.1 (K), R23.1
VIN: C75.1, U18.1 (IN), U18.3 (EN); also elsewhere on the board

Notes on the sheet:
DESIGN: AP2210 is drop in replacement
NOTE: Changed input cap to 1uF from reccomended value of 0.33uF
Should not have effect, but look here if something is wrong

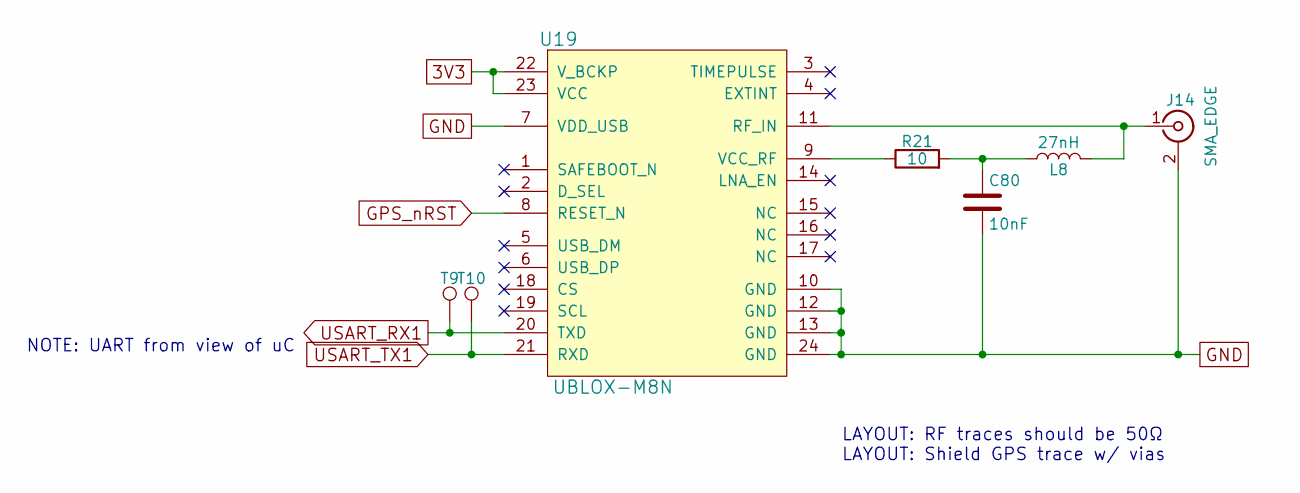
[picture p30: schematic GPS.sch]

Parts:
C80: 10nF; C_0603
J14: SMA_EDGE; EBAY_SMA
L8: 27nH; L_0603
R21: 10; R_0603
T9, T10: TP; 0603_TP
U19: UBLOX-M8N

Connections:
3V3: U19.22 (V_BCKP), U19.23 (VCC); also elsewhere on the board
GND: C80.2, J14.2 (Ext), U19.7 (VDD_USB), U19.10 (GND), U19.12 (GND), U19.13 (GND), U19.24 (GND); also elsewhere on the board
GPS_nRST: U19.8 (RESET_N); also elsewhere on the board
unnamed: C80.1, L8.1, R21.2
unnamed: J14.1 (In), L8.2, U19.11 (RF_IN)
unnamed: R21.1, U19.9 (VCC_RF)
USART_RX1: T9.1, U19.20 (TXD); also elsewhere on the board
USART_TX1: T10.1, U19.21 (RXD); also elsewhere on the board

Notes on the sheet:
NOTE: UART from view of uC
LAYOUT: RF traces should be 50Ω LAYOUT: Shield GPS trace w/ vias

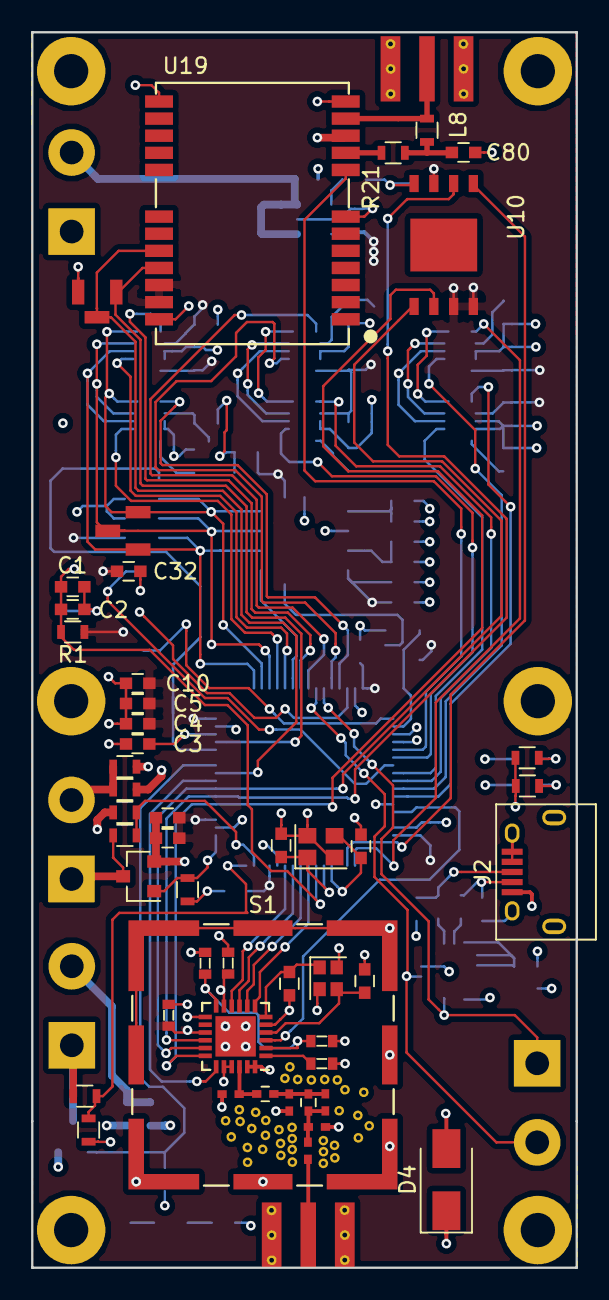
[picture p31: board Flight_computer_LT.kicad_pcb from above]

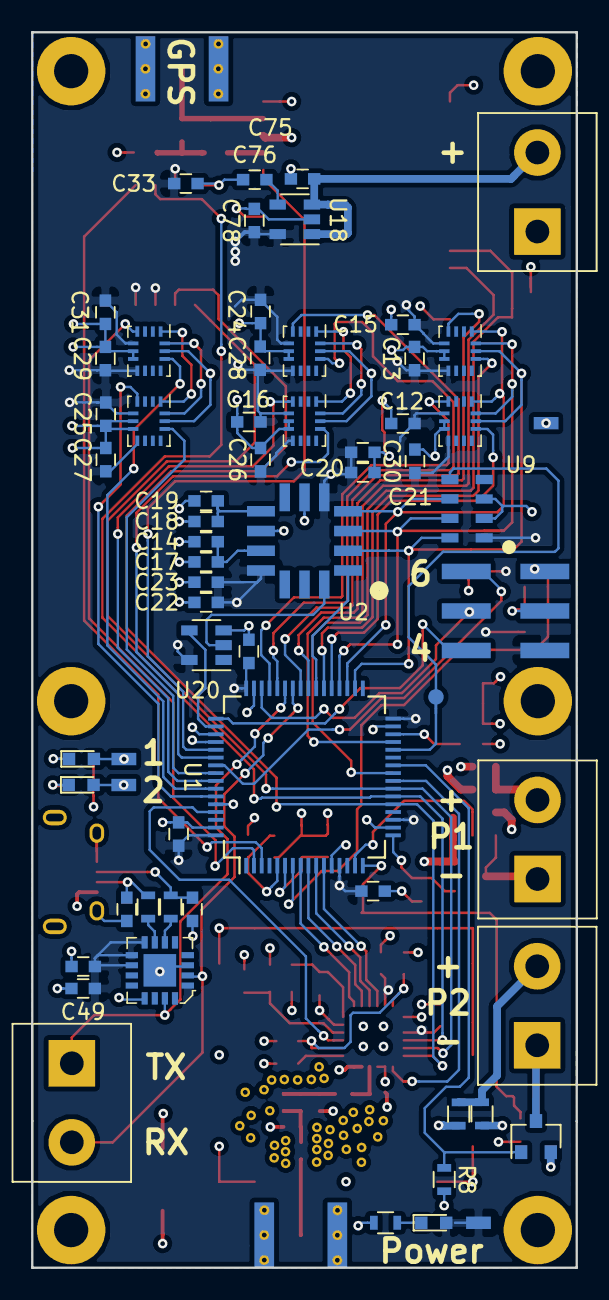
[picture p32: board Flight_computer_LT.kicad_pcb from below]

Board: 4 copper layers, 35.0 x 79.4 mm, 124 parts (63 on the bottom side), 76 nets.
