nsternie/live_telemetry/firmware/Atollic/Flight_Computer_Ground/Src/main.c

/**
  ******************************************************************************
  * File Name          : main.c
  * Description        : Main program body
  ******************************************************************************
  ** This notice applies to any and all portions of this file
  * that are not between comment pairs USER CODE BEGIN and
  * USER CODE END. Other portions of this file, whether 
  * inserted by the user or by software development tools
  * are owned by their respective copyright owners.
  *
  * COPYRIGHT(c) 2018 STMicroelectronics
  *
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
  ******************************************************************************
  */

/* Includes ------------------------------------------------------------------*/
#include "main.h"
#include "stm32f4xx_hal.h"

/* USER CODE BEGIN Includes */
#include "SX1280.h"
#include "flash.h"
#include "commandline.h"

/* USER CODE END Includes */

ADC_HandleTypeDef hadc1;

SPI_HandleTypeDef hspi1;
SPI_HandleTypeDef hspi2;

TIM_HandleTypeDef htim6;
TIM_HandleTypeDef htim7;
TIM_HandleTypeDef htim10;

UART_HandleTypeDef huart1;
UART_HandleTypeDef huart3;

/* USER CODE BEGIN PV */
volatile uint8_t radio_tim;
uint8_t uart1_in;
buffer uart1_buf;
uint8_t tx_pkt_cmd;
uint8_t radio_cmd;
uint8_t pkt_rdy;

/* USER CODE END PV */

void SystemClock_Config(void);
static void MX_GPIO_Init(void);
static void MX_ADC1_Init(void);
static void MX_SPI1_Init(void);
static void MX_SPI2_Init(void);
static void MX_TIM10_Init(void);
static void MX_USART1_UART_Init(void);
static void MX_USART3_UART_Init(void);
static void MX_TIM6_Init(void);
static void MX_TIM7_Init(void);

/* USER CODE BEGIN PFP */

/* USER CODE END PFP */

/* USER CODE BEGIN 0 */
#define LENGTH 23;
void stuff_telem(uint8_t *unstuffed, uint8_t *stuffed){
 const uint8_t *end = unstuffed + LENGTH;
 uint8_t *code_ptr = stuffed++;
 uint8_t code = 0x01;

 while (unstuffed < end){
   if (*unstuffed == '\n') {
     *code_ptr = code;
     code_ptr = stuffed++;
     code = 0x01;
   }
   else {
     *stuffed++ = *unstuffed;
     if (++code == 0xFF){
       *code_ptr = code;
       code_ptr = stuffed++;
       code = 0x01;
     }
   }
   unstuffed++;
 }
 *stuffed = '\n';

 *code_ptr = code;
 code_ptr = stuffed++;
 code = 0x01;
}
/* USER CODE END 0 */

int main(void)
{

  /* MCU Configuration----------------------------------------------------------*/

  /* Reset of all peripherals, Initializes the Flash interface and the Systick. */
  HAL_Init();

  /* Configure the system clock */
  SystemClock_Config();

  /* Initialize all configured peripherals */
  MX_GPIO_Init();
  MX_ADC1_Init();
  MX_SPI1_Init();
  MX_SPI2_Init();
  MX_TIM10_Init();
  MX_USART1_UART_Init();
  MX_USART3_UART_Init();
  MX_TIM6_Init();
  MX_TIM7_Init();

  /* USER CODE BEGIN 2 */
  //Local Vars
  uint8_t RXData[30] = {0};
  uint8_t TXData[30] = {0};
  uint8_t stuffed_pkt[25] = {0};
  uint8_t temp_pkt[5] = {0};
  uint8_t radio_tim_count = 0;
  pkt_rdy = 0;

  uint8_t line[160] = {0};
  snprintf(line, sizeof(line), "test\n\r");
  HAL_UART_Transmit(&huart1, line, strlen(line), 0xff);

  //Init CS pins to default state
  HAL_GPIO_WritePin(GYRO1_CS_GPIO_Port, GYRO1_CS_Pin, 1);
  HAL_GPIO_WritePin(GYRO2_CS_GPIO_Port, GYRO2_CS_Pin, 1);
  HAL_GPIO_WritePin(GYRO3_CS_GPIO_Port, GYRO3_CS_Pin, 1);
  HAL_GPIO_WritePin(GYRO4_CS_GPIO_Port, GYRO4_CS_Pin, 1);
  HAL_GPIO_WritePin(GYRO5_CS_GPIO_Port, GYRO5_CS_Pin, 1);
  HAL_GPIO_WritePin(GYRO6_CS_GPIO_Port, GYRO6_CS_Pin, 1);
  HAL_GPIO_WritePin(MS5607_CS_GPIO_Port, MS5607_CS_Pin, 1);
  HAL_GPIO_WritePin(ADXL_CS_GPIO_Port, ADXL_CS_Pin, 1);
  HAL_GPIO_WritePin(GPS_nRST_GPIO_Port, GPS_nRST_Pin, 1);
  HAL_GPIO_WritePin(MEM_CS_GPIO_Port, MEM_CS_Pin, 1);
  HAL_GPIO_WritePin(CS_Radio_GPIO_Port, CS_Radio_Pin, 1);

  //Cmd Interface Init
  buffer_init(&uart1_buf, UART_BUFFER_SIZE, 1);
  HAL_UART_Receive_IT(&huart1, &uart1_in, 1);

  //Init radio
  init_radio();

  HAL_Delay(100);
  radio_RXMode();

  //Start 100hz radio timer
  HAL_TIM_Base_Init(&htim7);
  HAL_TIM_Base_Start_IT(&htim7);



  while(1){
	  if(pkt_rdy){
		  //Receive packet if one comes in
		  radio_getPktStatus();

		  //Get RX Buffer Status
		  radio_getRXBufferStatus();

		  //Read buffer
		  radio_rxPacket(RXData);
		  uint8_t *pArray = &RXData[3];


		  RXData[25] = radio_getPktStatus();
		  if(RXData[3] == 0xFF){
			  //Do nothing if callsign packet
		  }
		  else{
			  stuff_telem(pArray, stuffed_pkt);
			  HAL_UART_Transmit(&huart1, stuffed_pkt, 25, 0xff);
		  }

		  //Clear IRQs
		  radio_clearInterrupt();
		  pkt_rdy = 0;

		  if(tx_pkt_cmd){
		  		  HAL_Delay(1); //Adjust to get timing right
		  		  uint8_t temp_pkt[30] = {0};
		  		  temp_pkt[2] = radio_cmd;
		  		  temp_pkt[3] = 0xFF - radio_cmd;
		  		  radio_txPacket(temp_pkt);
		  		  tx_pkt_cmd = 0;
		  		  HAL_Delay(100);
		  	  }
		  else{
			  radio_RXMode();
		  }
	  }

	  parse_buffer(&uart1_buf);
  }

//  while(1){
//	  if(radio_tim == 1){
//		  volatile uint8_t pkt_rdy = radio_checkRxPkt();
//		  if(pkt_rdy){
//			  //Read from FIFO
//			  TXData[0] = 0x7F;
//			  TXData[1] = 0x00;
//			  HAL_GPIO_WritePin(RADIO_CS_GPIO_Port, RADIO_CS_Pin, 0);
//			  HAL_SPI_TransmitReceive(&hspi1, TXData, RXData, 23, 0xff);
//			  HAL_GPIO_WritePin(RADIO_CS_GPIO_Port, RADIO_CS_Pin, 1);
//
//			  uint8_t RSSI = radio_readRSSI();
//
//			  //snprintf(line, sizeof(line), "%d %d %d %d %d %d %d %d %d %d %d %d %d %d %d %d %d %d %d\r\n\0", RXData[1], RXData[2], RXData[3], RXData[4], RXData[5], RXData[6], RXData[7], RXData[8], RXData[9], RXData[10], RXData[11], RXData[12], RXData[13], RXData[14], RXData[15], RXData[16], RXData[17], RXData[18], RSSI);
//			  //HAL_UART_Transmit(&huart1, line, strlen(line), 0xff);
//			  RXData[23] = RSSI;
//			  uint8_t *pArray = &RXData[1];
//			  stuff_telem(pArray, stuffed_pkt);
//			  HAL_UART_Transmit(&huart1, stuffed_pkt, 25, 0xff);
//
//			  if(tx_pkt_cmd){
//				  //Transmitt a command packet
//				  HAL_Delay(10); //Adjust to get timing right
//				  temp_pkt[1] = radio_cmd;
//				  temp_pkt[2] = 0xFF - radio_cmd;
//				  radio_txPacket(temp_pkt);
//				  tx_pkt_cmd = 0;
//				  HAL_Delay(150);
//			  }
//
//			  TXData[0] = 0x07 | 0x80;
//			  TXData[1] = 0x04;
//			  HAL_GPIO_WritePin(RADIO_CS_GPIO_Port, RADIO_CS_Pin, 0);
//			  HAL_SPI_TransmitReceive(&hspi1, TXData, RXData, 2, 0xff);
//			  HAL_GPIO_WritePin(RADIO_CS_GPIO_Port, RADIO_CS_Pin, 1);
//		  }
//
//		radio_tim = 0;
//		radio_tim_count += 1;
//		if(radio_tim_count >= 100){
//			radio_tim_count = 0;
//		}
//	  }
//
//	  parse_buffer(&uart1_buf);
//  }

  /* USER CODE END 2 */

  /* Infinite loop */
  /* USER CODE BEGIN WHILE */
  while (1){

  /* USER CODE END WHILE */

  /* USER CODE BEGIN 3 */

  }
  /* USER CODE END 3 */

}

/** System Clock Configuration
*/
void SystemClock_Config(void)
{

  RCC_OscInitTypeDef RCC_OscInitStruct;
  RCC_ClkInitTypeDef RCC_ClkInitStruct;

    /**Configure the main internal regulator output voltage 
    */
  __HAL_RCC_PWR_CLK_ENABLE();

  __HAL_PWR_VOLTAGESCALING_CONFIG(PWR_REGULATOR_VOLTAGE_SCALE1);

    /**Initializes the CPU, AHB and APB busses clocks 
    */
  RCC_OscInitStruct.OscillatorType = RCC_OSCILLATORTYPE_HSI;
  RCC_OscInitStruct.HSIState = RCC_HSI_ON;
  RCC_OscInitStruct.HSICalibrationValue = 16;
  RCC_OscInitStruct.PLL.PLLState = RCC_PLL_ON;
  RCC_OscInitStruct.PLL.PLLSource = RCC_PLLSOURCE_HSI;
  RCC_OscInitStruct.PLL.PLLM = 8;
  RCC_OscInitStruct.PLL.PLLN = 180;
  RCC_OscInitStruct.PLL.PLLP = RCC_PLLP_DIV2;
  RCC_OscInitStruct.PLL.PLLQ = 2;
  RCC_OscInitStruct.PLL.PLLR = 2;
  if (HAL_RCC_OscConfig(&RCC_OscInitStruct) != HAL_OK)
  {
    _Error_Handler(__FILE__, __LINE__);
  }

    /**Activate the Over-Drive mode 
    */
  if (HAL_PWREx_EnableOverDrive() != HAL_OK)
  {
    _Error_Handler(__FILE__, __LINE__);
  }

    /**Initializes the CPU, AHB and APB busses clocks 
    */
  RCC_ClkInitStruct.ClockType = RCC_CLOCKTYPE_HCLK|RCC_CLOCKTYPE_SYSCLK
                              |RCC_CLOCKTYPE_PCLK1|RCC_CLOCKTYPE_PCLK2;
  RCC_ClkInitStruct.SYSCLKSource = RCC_SYSCLKSOURCE_PLLCLK;
  RCC_ClkInitStruct.AHBCLKDivider = RCC_SYSCLK_DIV1;
  RCC_ClkInitStruct.APB1CLKDivider = RCC_HCLK_DIV4;
  RCC_ClkInitStruct.APB2CLKDivider = RCC_HCLK_DIV2;

  if (HAL_RCC_ClockConfig(&RCC_ClkInitStruct, FLASH_LATENCY_5) != HAL_OK)
  {
    _Error_Handler(__FILE__, __LINE__);
  }

    /**Configure the Systick interrupt time 
    */
  HAL_SYSTICK_Config(HAL_RCC_GetHCLKFreq()/1000);

    /**Configure the Systick 
    */
  HAL_SYSTICK_CLKSourceConfig(SYSTICK_CLKSOURCE_HCLK);

  /* SysTick_IRQn interrupt configuration */
  HAL_NVIC_SetPriority(SysTick_IRQn, 0, 0);
}

/* ADC1 init function */
static void MX_ADC1_Init(void)
{

  ADC_ChannelConfTypeDef sConfig;

    /**Configure the global features of the ADC (Clock, Resolution, Data Alignment and number of conversion) 
    */
  hadc1.Instance = ADC1;
  hadc1.Init.ClockPrescaler = ADC_CLOCK_SYNC_PCLK_DIV4;
  hadc1.Init.Resolution = ADC_RESOLUTION_12B;
  hadc1.Init.ScanConvMode = DISABLE;
  hadc1.Init.ContinuousConvMode = DISABLE;
  hadc1.Init.DiscontinuousConvMode = DISABLE;
  hadc1.Init.ExternalTrigConvEdge = ADC_EXTERNALTRIGCONVEDGE_NONE;
  hadc1.Init.ExternalTrigConv = ADC_SOFTWARE_START;
  hadc1.Init.DataAlign = ADC_DATAALIGN_RIGHT;
  hadc1.Init.NbrOfConversion = 1;
  hadc1.Init.DMAContinuousRequests = DISABLE;
  hadc1.Init.EOCSelection = ADC_EOC_SINGLE_CONV;
  if (HAL_ADC_Init(&hadc1) != HAL_OK)
  {
    _Error_Handler(__FILE__, __LINE__);
  }

    /**Configure for the selected ADC regular channel its corresponding rank in the sequencer and its sample time. 
    */
  sConfig.Channel = ADC_CHANNEL_2;
  sConfig.Rank = 1;
  sConfig.SamplingTime = ADC_SAMPLETIME_3CYCLES;
  if (HAL_ADC_ConfigChannel(&hadc1, &sConfig) != HAL_OK)
  {
    _Error_Handler(__FILE__, __LINE__);
  }

}

/* SPI1 init function */
static void MX_SPI1_Init(void)
{

  /* SPI1 parameter configuration*/
  hspi1.Instance = SPI1;
  hspi1.Init.Mode = SPI_MODE_MASTER;
  hspi1.Init.Direction = SPI_DIRECTION_2LINES;
  hspi1.Init.DataSize = SPI_DATASIZE_8BIT;
  hspi1.Init.CLKPolarity = SPI_POLARITY_LOW;
  hspi1.Init.CLKPhase = SPI_PHASE_1EDGE;
  hspi1.Init.NSS = SPI_NSS_SOFT;
  hspi1.Init.BaudRatePrescaler = SPI_BAUDRATEPRESCALER_16;
  hspi1.Init.FirstBit = SPI_FIRSTBIT_MSB;
  hspi1.Init.TIMode = SPI_TIMODE_DISABLE;
  hspi1.Init.CRCCalculation = SPI_CRCCALCULATION_DISABLE;
  hspi1.Init.CRCPolynomial = 10;
  if (HAL_SPI_Init(&hspi1) != HAL_OK)
  {
    _Error_Handler(__FILE__, __LINE__);
  }

}

/* SPI2 init function */
static void MX_SPI2_Init(void)
{

  /* SPI2 parameter configuration*/
  hspi2.Instance = SPI2;
  hspi2.Init.Mode = SPI_MODE_MASTER;
  hspi2.Init.Direction = SPI_DIRECTION_2LINES;
  hspi2.Init.DataSize = SPI_DATASIZE_8BIT;
  hspi2.Init.CLKPolarity = SPI_POLARITY_LOW;
  hspi2.Init.CLKPhase = SPI_PHASE_1EDGE;
  hspi2.Init.NSS = SPI_NSS_SOFT;
  hspi2.Init.BaudRatePrescaler = SPI_BAUDRATEPRESCALER_8;
  hspi2.Init.FirstBit = SPI_FIRSTBIT_MSB;
  hspi2.Init.TIMode = SPI_TIMODE_DISABLE;
  hspi2.Init.CRCCalculation = SPI_CRCCALCULATION_DISABLE;
  hspi2.Init.CRCPolynomial = 10;
  if (HAL_SPI_Init(&hspi2) != HAL_OK)
  {
    _Error_Handler(__FILE__, __LINE__);
  }

}

/* TIM6 init function */
static void MX_TIM6_Init(void)
{

  TIM_MasterConfigTypeDef sMasterConfig;

  htim6.Instance = TIM6;
  htim6.Init.Prescaler = 17999;
  htim6.Init.CounterMode = TIM_COUNTERMODE_UP;
  htim6.Init.Period = 99;
  if (HAL_TIM_Base_Init(&htim6) != HAL_OK)
  {
    _Error_Handler(__FILE__, __LINE__);
  }

  sMasterConfig.MasterOutputTrigger = TIM_TRGO_RESET;
  sMasterConfig.MasterSlaveMode = TIM_MASTERSLAVEMODE_DISABLE;
  if (HAL_TIMEx_MasterConfigSynchronization(&htim6, &sMasterConfig) != HAL_OK)
  {
    _Error_Handler(__FILE__, __LINE__);
  }

}

/* TIM7 init function */
static void MX_TIM7_Init(void)
{

  TIM_MasterConfigTypeDef sMasterConfig;

  htim7.Instance = TIM7;
  htim7.Init.Prescaler = 1799;
  htim7.Init.CounterMode = TIM_COUNTERMODE_UP;
  htim7.Init.Period = 499;
  if (HAL_TIM_Base_Init(&htim7) != HAL_OK)
  {
    _Error_Handler(__FILE__, __LINE__);
  }

  sMasterConfig.MasterOutputTrigger = TIM_TRGO_RESET;
  sMasterConfig.MasterSlaveMode = TIM_MASTERSLAVEMODE_DISABLE;
  if (HAL_TIMEx_MasterConfigSynchronization(&htim7, &sMasterConfig) != HAL_OK)
  {
    _Error_Handler(__FILE__, __LINE__);
  }

}

/* TIM10 init function */
static void MX_TIM10_Init(void)
{

  htim10.Instance = TIM10;
  htim10.Init.Prescaler = 1799;
  htim10.Init.CounterMode = TIM_COUNTERMODE_UP;
  htim10.Init.Period = 999;
  htim10.Init.ClockDivision = TIM_CLOCKDIVISION_DIV1;
  if (HAL_TIM_Base_Init(&htim10) != HAL_OK)
  {
    _Error_Handler(__FILE__, __LINE__);
  }

}

/* USART1 init function */
static void MX_USART1_UART_Init(void)
{

  huart1.Instance = USART1;
  huart1.Init.BaudRate = 115200;
  huart1.Init.WordLength = UART_WORDLENGTH_8B;
  huart1.Init.StopBits = UART_STOPBITS_1;
  huart1.Init.Parity = UART_PARITY_NONE;
  huart1.Init.Mode = UART_MODE_TX_RX;
  huart1.Init.HwFlowCtl = UART_HWCONTROL_NONE;
  huart1.Init.OverSampling = UART_OVERSAMPLING_16;
  if (HAL_UART_Init(&huart1) != HAL_OK)
  {
    _Error_Handler(__FILE__, __LINE__);
  }

}

/* USART3 init function */
static void MX_USART3_UART_Init(void)
{

  huart3.Instance = USART3;
  huart3.Init.BaudRate = 9600;
  huart3.Init.WordLength = UART_WORDLENGTH_8B;
  huart3.Init.StopBits = UART_STOPBITS_1;
  huart3.Init.Parity = UART_PARITY_NONE;
  huart3.Init.Mode = UART_MODE_TX_RX;
  huart3.Init.HwFlowCtl = UART_HWCONTROL_NONE;
  huart3.Init.OverSampling = UART_OVERSAMPLING_16;
  if (HAL_UART_Init(&huart3) != HAL_OK)
  {
    _Error_Handler(__FILE__, __LINE__);
  }

}

/** Configure pins as 
        * Analog 
        * Input 
        * Output
        * EVENT_OUT
        * EXTI
*/
static void MX_GPIO_Init(void)
{

  GPIO_InitTypeDef GPIO_InitStruct;

  /* GPIO Ports Clock Enable */
  __HAL_RCC_GPIOC_CLK_ENABLE();
  __HAL_RCC_GPIOA_CLK_ENABLE();
  __HAL_RCC_GPIOB_CLK_ENABLE();
  __HAL_RCC_GPIOD_CLK_ENABLE();

  /*Configure GPIO pin Output Level */
  HAL_GPIO_WritePin(GPIOC, MEM_CS_Pin|CS_Radio_Pin|GYRO5_CS_Pin|GYRO4_CS_Pin 
                          |ADXL_CS_Pin|LED1_Pin|LED2_Pin|GPS_nRST_Pin, GPIO_PIN_RESET);

  /*Configure GPIO pin Output Level */
  HAL_GPIO_WritePin(GPIOA, PYRO_2_FIRE_Pin|GYRO1_CS_Pin, GPIO_PIN_RESET);

  /*Configure GPIO pin Output Level */
  HAL_GPIO_WritePin(GPIOB, PYRO_1_FIRE_Pin|MS5607_CS_Pin|GYRO3_CS_Pin|GYRO2_CS_Pin 
                          |nRST_RADIO_Pin, GPIO_PIN_RESET);

  /*Configure GPIO pin Output Level */
  HAL_GPIO_WritePin(GYRO6_CS_GPIO_Port, GYRO6_CS_Pin, GPIO_PIN_RESET);

  /*Configure GPIO pins : GYRO2_INT_Pin DIO1_Radio_Pin DIO2_Radio_Pin DIO3_Radio_Pin 
                           GYRO4_INT_Pin */
  GPIO_InitStruct.Pin = GYRO2_INT_Pin|DIO1_Radio_Pin|DIO2_Radio_Pin|DIO3_Radio_Pin 
                          |GYRO4_INT_Pin;
  GPIO_InitStruct.Mode = GPIO_MODE_IT_RISING;
  GPIO_InitStruct.Pull = GPIO_NOPULL;
  HAL_GPIO_Init(GPIOC, &GPIO_InitStruct);

  /*Configure GPIO pins : MEM_CS_Pin CS_Radio_Pin LED1_Pin LED2_Pin 
                           GPS_nRST_Pin */
  GPIO_InitStruct.Pin = MEM_CS_Pin|CS_Radio_Pin|LED1_Pin|LED2_Pin 
                          |GPS_nRST_Pin;
  GPIO_InitStruct.Mode = GPIO_MODE_OUTPUT_PP;
  GPIO_InitStruct.Pull = GPIO_NOPULL;
  GPIO_InitStruct.Speed = GPIO_SPEED_FREQ_LOW;
  HAL_GPIO_Init(GPIOC, &GPIO_InitStruct);

  /*Configure GPIO pin : BUSY_Radio_Pin */
  GPIO_InitStruct.Pin = BUSY_Radio_Pin;
  GPIO_InitStruct.Mode = GPIO_MODE_INPUT;
  GPIO_InitStruct.Pull = GPIO_NOPULL;
  HAL_GPIO_Init(BUSY_Radio_GPIO_Port, &GPIO_InitStruct);

  /*Configure GPIO pin : PYRO_2_FIRE_Pin */
  GPIO_InitStruct.Pin = PYRO_2_FIRE_Pin;
  GPIO_InitStruct.Mode = GPIO_MODE_OUTPUT_PP;
  GPIO_InitStruct.Pull = GPIO_NOPULL;
  GPIO_InitStruct.Speed = GPIO_SPEED_FREQ_LOW;
  HAL_GPIO_Init(PYRO_2_FIRE_GPIO_Port, &GPIO_InitStruct);

  /*Configure GPIO pins : PYRO_1_FIRE_Pin nRST_RADIO_Pin */
  GPIO_InitStruct.Pin = PYRO_1_FIRE_Pin|nRST_RADIO_Pin;
  GPIO_InitStruct.Mode = GPIO_MODE_OUTPUT_PP;
  GPIO_InitStruct.Pull = GPIO_NOPULL;
  GPIO_InitStruct.Speed = GPIO_SPEED_FREQ_LOW;
  HAL_GPIO_Init(GPIOB, &GPIO_InitStruct);

  /*Configure GPIO pins : MS5607_CS_Pin GYRO3_CS_Pin GYRO2_CS_Pin */
  GPIO_InitStruct.Pin = MS5607_CS_Pin|GYRO3_CS_Pin|GYRO2_CS_Pin;
  GPIO_InitStruct.Mode = GPIO_MODE_OUTPUT_PP;
  GPIO_InitStruct.Pull = GPIO_NOPULL;
  GPIO_InitStruct.Speed = GPIO_SPEED_FREQ_HIGH;
  HAL_GPIO_Init(GPIOB, &GPIO_InitStruct);

  /*Configure GPIO pins : GYRO5_CS_Pin GYRO4_CS_Pin ADXL_CS_Pin */
  GPIO_InitStruct.Pin = GYRO5_CS_Pin|GYRO4_CS_Pin|ADXL_CS_Pin;
  GPIO_InitStruct.Mode = GPIO_MODE_OUTPUT_PP;
  GPIO_InitStruct.Pull = GPIO_NOPULL;
  GPIO_InitStruct.Speed = GPIO_SPEED_FREQ_HIGH;
  HAL_GPIO_Init(GPIOC, &GPIO_InitStruct);

  /*Configure GPIO pins : GYRO1_INT_Pin GYRO5_INT_Pin ADXL_DRDY_Pin */
  GPIO_InitStruct.Pin = GYRO1_INT_Pin|GYRO5_INT_Pin|ADXL_DRDY_Pin;
  GPIO_InitStruct.Mode = GPIO_MODE_IT_RISING;
  GPIO_InitStruct.Pull = GPIO_NOPULL;
  HAL_GPIO_Init(GPIOA, &GPIO_InitStruct);

  /*Configure GPIO pin : GYRO1_CS_Pin */
  GPIO_InitStruct.Pin = GYRO1_CS_Pin;
  GPIO_InitStruct.Mode = GPIO_MODE_OUTPUT_PP;
  GPIO_InitStruct.Pull = GPIO_NOPULL;
  GPIO_InitStruct.Speed = GPIO_SPEED_FREQ_HIGH;
  HAL_GPIO_Init(GYRO1_CS_GPIO_Port, &GPIO_InitStruct);

  /*Configure GPIO pin : GYRO6_CS_Pin */
  GPIO_InitStruct.Pin = GYRO6_CS_Pin;
  GPIO_InitStruct.Mode = GPIO_MODE_OUTPUT_PP;
  GPIO_InitStruct.Pull = GPIO_NOPULL;
  GPIO_InitStruct.Speed = GPIO_SPEED_FREQ_HIGH;
  HAL_GPIO_Init(GYRO6_CS_GPIO_Port, &GPIO_InitStruct);

  /*Configure GPIO pins : GYRO6_INT_Pin GYRO3_INT_Pin */
  GPIO_InitStruct.Pin = GYRO6_INT_Pin|GYRO3_INT_Pin;
  GPIO_InitStruct.Mode = GPIO_MODE_IT_RISING;
  GPIO_InitStruct.Pull = GPIO_NOPULL;
  HAL_GPIO_Init(GPIOB, &GPIO_InitStruct);

  /* EXTI interrupt init*/
  HAL_NVIC_SetPriority(EXTI1_IRQn, 1, 0);
  HAL_NVIC_EnableIRQ(EXTI1_IRQn);

  HAL_NVIC_SetPriority(EXTI2_IRQn, 1, 0);
  HAL_NVIC_EnableIRQ(EXTI2_IRQn);

  HAL_NVIC_SetPriority(EXTI3_IRQn, 1, 0);
  HAL_NVIC_EnableIRQ(EXTI3_IRQn);

  HAL_NVIC_SetPriority(EXTI9_5_IRQn, 1, 0);
  HAL_NVIC_EnableIRQ(EXTI9_5_IRQn);

  HAL_NVIC_SetPriority(EXTI15_10_IRQn, 1, 0);
  HAL_NVIC_EnableIRQ(EXTI15_10_IRQn);

}

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
