nsternie/live_telemetry/firmware/Atollic/Flight_Computer_Ground/Flight_Computer_Ground.ioc

Mcu.UserName=STM32F446RETx
PA1.GPIO_Label=PYRO_2_SENSE
PA1.Signal=ADCx_IN1
PA10.Signal=USART1_RX
PA11.GPIO_Label=GYRO1_CS
PA11.Signal=GPIO_Output
PA12.GPIO_Label=GYRO5_INT
PA12.Signal=GPXTI12
PA13.Signal=SYS_JTMS-SWDIO
PA14.Signal=SYS_JTCK-SWCLK
PA15.GPIO_Label=ADXL_DRDY
PA15.Signal=GPXTI15
PA2.GPIO_Label=PYRO_1_SENSE
PA2.Signal=ADCx_IN2
PA3.GPIO_Label=PYRO_2_FIRE
PA3.Signal=GPIO_Output
PA5.Signal=SPI1_SCK
PA6.Signal=SPI1_MISO
PA7.Signal=SPI1_MOSI
PA8.GPIO_Label=GYRO1_INT
PA8.Signal=GPXTI8
PA9.Signal=USART1_TX
PB0.GPIO_Label=PYRO_1_FIRE
PB0.Signal=GPIO_Output
PB10.Signal=USART3_TX
PB13.Signal=SPI2_SCK
PB14.Signal=SPI2_MISO
PB15.Signal=SPI2_MOSI
PB2.GPIO_Label=MS5607_CS
PB2.Signal=GPIO_Output
PB3.Signal=SYS_JTDO-SWO
PB4.GPIO_Label=GYRO3_CS
PB4.Signal=GPIO_Output
PB5.GPIO_Label=GYRO6_INT
PB5.Signal=GPXTI5
PB6.GPIO_Label=GYRO2_CS
PB6.Signal=GPIO_Output
PB7.GPIO_Label=GYRO3_INT
PB7.Signal=GPXTI7
PB8.GPIO_Label=nRST_RADIO
PB8.Signal=GPIO_Output
PC0.GPIO_Label=BUSY_Radio
PC0.Signal=GPIO_Input
PC1.GPIO_Label=DIO1_Radio
PC1.Signal=GPXTI1
PC10.GPIO_Label=LED1
PC10.Signal=GPIO_Output
PC11.GPIO_Label=LED2
PC11.Signal=GPIO_Output
PC12.GPIO_Label=GPS_nRST
PC12.Signal=GPIO_Output
PC13.GPIO_Label=GYRO2_INT
PC13.Signal=GPXTI13
PC14-OSC32_IN.GPIO_Label=MEM_CS
PC14-OSC32_IN.Signal=GPIO_Output
PC2.GPIO_Label=DIO2_Radio
PC2.Signal=GPXTI2
PC3.GPIO_Label=DIO3_Radio
PC3.Signal=GPXTI3
PC4.GPIO_Label=CS_Radio
PC4.Signal=GPIO_Output
PC5.Signal=USART3_RX
PC6.GPIO_Label=GYRO5_CS
PC6.Signal=GPIO_Output
PC7.GPIO_Label=GYRO4_CS
PC7.Signal=GPIO_Output
PC8.GPIO_Label=ADXL_CS
PC8.Signal=GPIO_Output
PC9.GPIO_Label=GYRO4_INT
PC9.Signal=GPXTI9
PD2.GPIO_Label=GYRO6_CS
PD2.Signal=GPIO_Output
