nsternie/live_telemetry/firmware/Atollic/Flight_Computer_Rocket/Src/format.h

/*
 * format.h
 *
 *  Created on: Jan 11, 2018
 *      Author: Nick Serenberg
 */

#ifndef FORMAT_H_
#define FORMAT_H_


#define PACKET_TYPE_MILLIS  0
#define PACKET_TYPE_MICROS  1
#define PACKET_TYPE_STRING  2
#define PACKET_TYPE_GYRO    3
#define PACKET_TYPE_ACCEL   4

#endif /* FORMAT_H_ */
