nsternie/live_telemetry/gui/gui.py

import sys
import os
import pandas as pd
from PyQt5 import QtGui, QtCore
import pyqtgraph as pg
import serial
import serial.tools.list_ports
import struct
from bitstring import BitArray
from PlotDefinition import PlotDefinition
import ctypes
from datetime import datetime
from math import *

#TODO: Live Map - not impossible but will require at least a week of development time possibly

#apparently I need to mess with process ids just to get the logo in the task bar
myappid = 'MASA.LiveTelem.GroundStationUI.1' # arbitrary string
ctypes.windll.shell32.SetCurrentProcessExplicitAppUserModelID(myappid)

ranging = False

#initialize run
if len(sys.argv) > 1:
    run_name = sys.argv[1]
else:
    run_name = input("Enter run name: ")
    if len(run_name) == 0:
        run_name = 'test'

if not os.path.exists("data/" + run_name + "/"):
    os.makedirs("data/" + run_name + "/")

#logging file counter
file_counter = 0

#open serial
ports = [p.device for p in serial.tools.list_ports.comports()]
serial_log = open('data/'+ run_name + "/serial_log.txt", "w+")
ser = serial.Serial(baudrate=115200, timeout=0.5)

#connect to port
def connect():
    global ser, ports_box
    if ser.isOpen():
        ser.close()
    try:
        ser.port = str(ports_box.currentText())
        ser.open()
        ser.readline()
        send_to_log("Connection established on %s" % str(ports_box.currentText()))
    except:
        send_to_log("Unable to connect to selected port or no ports available")

#scan for com ports
def scan():
    global ports_box
    ports = [p.device for p in serial.tools.list_ports.comports()]
    ports_box.clear()
    ports_box.addItems(ports)

#command log
command_log = open('data/'+ run_name + "/command_log.txt", "w+")

#data buffer
data = []

#initialize data arrays (for testing only)
#eventually load data from web database into dataframe
cols = ['time','packetType', 'packetNumber', 'lat', 'long', 'baro', 'maxAlt', 'gyroZ', 'velAccel', 'accelZ', 'rssi']
database = pd.DataFrame(columns=cols)

#data log
data_log = open('data/'+ run_name + "/data_log_"+ str(file_counter) +".csv", "w+")

def write_line(file, cols):
    for h in cols:
        file.write(str(h) + ",")
    file.write("\n")

#write header to data_log
write_line(data_log, cols)

#global vars
launch_alt = 0;
alt = 0;
packets_lost = 0;
last_packet = 0;
heart_beat = 0;
beats = "▖▘▝▗"
#beats = "MASA"

#initialize Qt
app = QtGui.QApplication([])

#timer
start_time = pg.ptime.time()

#top level
top = QtGui.QMainWindow()
w = QtGui.QWidget()
top.setCentralWidget(w)
top.setWindowTitle("MASA Live Telemetry Dashboard - " + run_name)
app.setWindowIcon(QtGui.QIcon('logos/logo.png'))

# layout grid for main window
top_layout = QtGui.QGridLayout()
main_area = QtGui.QWidget()
layout = QtGui.QGridLayout()
main_area.setLayout(layout)
w.setLayout(top_layout)
top_layout.addWidget(main_area, 0, 1)


#load graph settings
graph_settings = pd.read_csv('graph_settings.csv')

#number of points to store given tick_rate and seconds_to_store
def tickCalc(tr, s):
    return int(s/(tr/1000))

#max number of datapoints to store/retrieve
tick_rate = 150 #in ms (calculated limit at about 35-40 ms)
seconds_to_store = graph_settings['seconds'].max() #save as much memory as possible (keep only what's needed)
data_range = tickCalc(tick_rate, seconds_to_store) #this isn't right and I don't know why

#add area for tiled plots
plot_box = pg.GraphicsLayoutWidget()
plot_box.setBackground(None)

#tabs
tabs = QtGui.QTabWidget()
map_widget = QtGui.QWidget()
log_box  = QtGui.QTextEdit()
tabs.addTab(plot_box, "Telemetry")
tabs.addTab(log_box, "Log")
tabs.addTab(map_widget, "Map (WIP)")
layout.addWidget(tabs, 0, 1)

#add data area on side
data_fields = QtGui.QWidget()
data_layout = QtGui.QVBoxLayout()
top_layout.addWidget(data_fields, 0, 0)
data_fields.setLayout(data_layout)
#data_layout.addStretch(1)

#masa logo
logo = QtGui.QLabel()
#logo.setGeometry(0, 0, 300, 158)
logo.setPixmap(QtGui.QPixmap(os.getcwd() + "/logos/display2.png"))
logo.setAlignment(QtCore.Qt.AlignCenter)
data_layout.addWidget(logo)


#log setup
log_box.setReadOnly(True)

def send_to_log(text, status=True):
    time_obj = datetime.now().time()
    time = "<{:02d}:{:02d}:{:02d}> ".format(time_obj.hour, time_obj.minute, time_obj.second)
    log_box.append(time + text)
    if status:
        top.statusBar().showMessage(text)
    command_log.write(text + "\n")

send_to_log("Initialized instance: " + run_name, status=False)

#connection box (add to connection_layout)
connection = QtGui.QGroupBox("Connection")
data_layout.addWidget(connection)
connection_layout = QtGui.QGridLayout()
connection.setLayout(connection_layout)
scanButton = QtGui.QPushButton("Scan")
scanButton.clicked.connect(scan)
connection_layout.addWidget(scanButton, 1, 0)
connectButton = QtGui.QPushButton("Connect")
connectButton.clicked.connect(connect)
connection_layout.addWidget(connectButton, 2, 0)
ports_box = QtGui.QComboBox()
connection_layout.addWidget(ports_box, 0, 0)

#scan at initialization
scan()

#comm stats box (add to comm_layout)
comm_stats = QtGui.QGroupBox("Comm Stats")
data_layout.addWidget(comm_stats)
comm_layout = QtGui.QGridLayout()
comm_stats.setLayout(comm_layout)
comm_layout.addWidget(QtGui.QLabel("Packets Lost: "), 0, 0)
comm_layout.addWidget(QtGui.QLabel("RSSI: "), 1, 0)
comm_layout.addWidget(QtGui.QLabel("Status Byte: "), 2, 0)
packet_loss_label = QtGui.QLabel()
rssi_label = QtGui.QLabel()
status_byte_label = QtGui.QLabel("        ")
comm_layout.addWidget(packet_loss_label, 0, 1)
comm_layout.addWidget(rssi_label, 1, 1)
comm_layout.addWidget(status_byte_label, 2, 1)

#reset comm stats (packet loss)
def reset_comms():
    global packets_lost
    send_to_log("Comm stats reset. Dropped packets: " + str(packets_lost))
    packets_lost = 0

reset_comm_stats = QtGui.QPushButton("Reset")
reset_comm_stats.clicked.connect(reset_comms)
comm_layout.addWidget(reset_comm_stats, 3, 0)

#flight stats box (add to flight_layout)
flight_stats = QtGui.QGroupBox("Flight Stats")
data_layout.addWidget(flight_stats)
flight_layout = QtGui.QGridLayout()
flight_stats.setLayout(flight_layout)
flight_layout.addWidget(QtGui.QLabel("Altitude: "), 0, 0)
flight_layout.addWidget(QtGui.QLabel("Max Altitude: "), 1, 0)
flight_layout.addWidget(QtGui.QLabel("Velocity: "), 2, 0)
flight_layout.addWidget(QtGui.QLabel("Mach Number: "), 3, 0)
flight_layout.addWidget(QtGui.QLabel("Acceleration: "), 4, 0)
flight_layout.addWidget(QtGui.QLabel("Roll: "), 5, 0)
baroLabel = QtGui.QLabel()
baroUnits = QtGui.QLabel("ft (ASL)")
maxAltLabel = QtGui.QLabel("     ")
maxAltUnits = QtGui.QLabel("ft (ASL)")
velAccelLabel = QtGui.QLabel()
machLabel = QtGui.QLabel()
accelZLabel = QtGui.QLabel()
gyroZLabel = QtGui.QLabel()
flight_layout.addWidget(baroLabel, 0, 1)
flight_layout.addWidget(maxAltLabel, 1, 1)
flight_layout.addWidget(velAccelLabel, 2, 1)
flight_layout.addWidget(machLabel, 3 , 1)
flight_layout.addWidget(accelZLabel, 4, 1)
flight_layout.addWidget(gyroZLabel, 5, 1)
flight_layout.addWidget(baroUnits, 0, 2)
flight_layout.addWidget(maxAltUnits, 1, 2)
flight_layout.addWidget(QtGui.QLabel("m/s"), 2, 2)
flight_layout.addWidget(QtGui.QLabel("m/s^2"), 4, 2)
flight_layout.addWidget(QtGui.QLabel("Hz"), 5, 2)

#zero out altitude to account for ground level
def zero_altitude():
    global alt, launch_alt
    launch_alt = alt
    baroUnits.setText("ft (AGL)")
    maxAltUnits.setText("ft (AGL)")
    send_to_log("Launch altitude set to " + str(launch_alt) + " ft")

zeroAlt = QtGui.QPushButton("Zero Altitude")
zeroAlt.clicked.connect(zero_altitude)
flight_layout.addWidget(zeroAlt, 6, 0)

#haversine formula to calculate great circle distance
def haversine(lat1, long1, lat2, long2):
    r = 6.3781E6
    phi1 = radians(lat1)
    phi2 = radians(lat2)
    delta_p = lat2 - lat1
    delta_l = radians(long2 - long1)

    a = (sin(delta_p/2) ** 2) + (cos(phi1) * cos(phi2) * (sin(delta_l/2) ** 2))
    c = 2 * atan2(sqrt(a), sqrt(1-a))
    return r * c

#location box (add to location_layout)
location_stats = QtGui.QGroupBox("Location")
data_layout.addWidget(location_stats)
location_layout = QtGui.QGridLayout()
location_stats.setLayout(location_layout)
location_layout.addWidget(QtGui.QLabel("Latitude: "), 0, 0)
location_layout.addWidget(QtGui.QLabel("Longitude: "), 1, 0)
location_layout.addWidget(QtGui.QLabel("Range: "), 2, 0)
latLabel = QtGui.QLabel()
longLabel = QtGui.QLabel("              ")
range_label = QtGui.QLabel()
location_layout.addWidget(latLabel, 0, 1)
location_layout.addWidget(longLabel, 1, 1)
location_layout.addWidget(range_label, 2, 1)
location_layout.addWidget(QtGui.QLabel("deg"), 0, 2)
location_layout.addWidget(QtGui.QLabel("deg"), 1, 2)
location_layout.addWidget(QtGui.QLabel("m"), 2, 2)

#center data_field
#data_layout.addStretch(1)

#command line
command_widget = QtGui.QWidget()
command_layout = QtGui.QGridLayout()
layout.addWidget(command_widget, 2, 1)
command_widget.setLayout(command_layout)

# Raw Command
def raw_command():
    global raw_command_input, base_lat, base_long, ranging

    cmd = raw_command_input.text().split()

    if cmd[0] == 'setorigin':
        base_lat = float(cmd[1])
        base_long = float(cmd[2])
        ranging = True

    if ser.isOpen():
        ser.write((raw_command_input.text() + " \r").encode())
        send_to_log("Command sent: " + raw_command_input.text())
        raw_command_input.setText("")
    else:
        send_to_log("Unable to send command: " + raw_command_input.text())
        raw_command_input.setText("")

raw_command_input = QtGui.QLineEdit()
raw_command_send = QtGui.QPushButton("Send Command")
raw_command_send.clicked.connect(raw_command)
raw_command_input.returnPressed.connect(raw_command)
heart_beat_indicator = QtGui.QLabel("0")
command_layout.addWidget(raw_command_send, 0, 0)
command_layout.addWidget(raw_command_input, 0, 1)
command_layout.addWidget(heart_beat_indicator, 0, 2)


#Command Button Widget
#command_buttons_widget = QtGui.QWidget()
#command_buttons_layout = QtGui.QVBoxLayout()
#command_buttons_widget.setLayout(command_buttons_layout)
#command_buttons_layout.addStretch(1)
command_box = QtGui.QGroupBox("Command")
command_box_layout = QtGui.QVBoxLayout()
command_box.setLayout(command_box_layout)
#command_buttons_layout.addWidget(command_box)
#command_buttons_layout.addStretch(1)
#layout.addWidget(command_buttons_widget, 0, 2)
data_layout.addWidget(command_box)
data_layout.addStretch(1)

# Send Command
def send_command(cmd):
    if ser.isOpen():
        ser.write(cmd.encode())
        send_to_log("Command sent: " + cmd[:-2])
    else:
        send_to_log("Unable to send command: " + cmd[:-2])

#command buttons
command1 = QtGui.QPushButton("Begin Logging")
command1.clicked.connect(lambda: send_command("start_log \r"))
command_box_layout.addWidget(command1)
command2 = QtGui.QPushButton("Stop Logging")
command2.clicked.connect(lambda: send_command("stop_log \r"))
command_box_layout.addWidget(command2)
command3 = QtGui.QPushButton("Wipe Flash")
command3.clicked.connect(lambda: send_command("wipe_log \r"))
command_box_layout.addWidget(command3)

#map
map_tab_layout = QtGui.QGridLayout()
map = pg.ImageView()
map_tab_layout.addWidget(map, 0, 0)
map_widget.setLayout(map_tab_layout)

#menu bar
main_menu = top.menuBar()
main_menu.setNativeMenuBar(True)
file_menu = main_menu.addMenu('&File')
data_menu = main_menu.addMenu('&Data')

#quit application function
#in case more shutdown actions are needed later
def exit():
    ser.close()
    serial_log.close()
    command_log.close()
    data_log.close()
    app.quit()

#quit application menu item
quit = QtGui.QAction("&Quit", file_menu)
quit.setShortcut("Ctrl+Q")
quit.triggered.connect(exit)
file_menu.addAction(quit)

#clear data function
def clear():
    global file_counter, data_log, cols
    data_log.close()
    database.drop(database.index, inplace=True)
    file_counter += 1
    send_to_log("Data cleared. Now writing to " + 'data/'+ run_name + "/data_log_"+ str(file_counter) + ".csv")
    data_log = open('data/'+ run_name + "/data_log_"+ str(file_counter) + ".csv", "w+")
    write_line(data_log, cols)

#clear data menu item
clear_data = QtGui.QAction("&Clear Data", data_menu)
clear_data.setShortcut("Ctrl+D")
clear_data.triggered.connect(clear)
data_menu.addAction(clear_data)

#list for easy iteration through plots
plots = []

#for each plot in parameters
for i in range(len(graph_settings.index)):
    #get parameters for plot
    row = graph_settings.ix[i]

    #plot location on screen
    subplot = (row['row'], row['col'])

    #initialize plot and add to list
    plots.append(PlotDefinition(subplot, title=row['title'], xlabel=row['xlabel'], ylabel=row['ylabel'], data_range=tickCalc(tick_rate, row['seconds'])))

    #set x data
    plots[i].setX(row['x'])

    #parse y data
    ys = row['y'].split(' | ')
    pens = row['pen'].split(' | ')
    aliases = row['alias'].split(' | ')
    params = zip(ys, pens, aliases)

    #push y data to plot
    for param in params:
        plots[i].addY(param)

    #make plot and push to window
    plots[i].makePlot(plot_box, show_legend=bool(row['legend']), show_grid=bool(row['grid']))

#update function runs on each tick
def update():
    global database, cols, ser, alt, packets_lost, last_packet, serial_log, data_log, heart_beat

    #get data
    try:
        if ser.isOpen():
            packet = ser.readline()
            if packet == b"Commandline works!\r\n":
                send_to_log("response: Commandline works!")
            serial_log.write(str(packet)+ "\n")
            # Unstuff the packet
            unstuffed = b''
            try:
                index = int(packet[0])
            except:
                return
            for n in range(1, len(packet)):
                temp = packet[n:n+1]
                if(n == index):
                    index = int(packet[n])+n
                    temp = b'\n'
                unstuffed = unstuffed + temp
            packet = unstuffed

            #parse data into array
            data = []
            data.append(pg.ptime.time() - start_time) #time

            byte_rep = packet[0:1]
            data.append(BitArray(bytes=byte_rep).bin) #status byte

            byte_rep = packet[1:3]
            data.append(struct.unpack("<h", byte_rep)[0]) #packet number

            byte_rep = packet[3:7]
            data.append(struct.unpack("<f", byte_rep)[0]) #lat

            byte_rep = packet[7:11]
            data.append(struct.unpack("<f", byte_rep)[0]) #long

            byte_rep = packet[11:13]
            data.append(struct.unpack("<h", byte_rep)[0]) #baro

            byte_rep = packet[13:15]
            data.append(struct.unpack("<h", byte_rep)[0]) #maxAlt

            byte_rep = packet[15:17]
            data.append(struct.unpack("<h", byte_rep)[0]/360) #gyroZ

            byte_rep = packet[17:19]
            data.append(struct.unpack("<h", byte_rep)[0]) #velAccel

            byte_rep = packet[19:22]
            accelZ = bin(struct.unpack('<I', byte_rep + b'\xFF')[0])[2:]
            data.append(BitArray(bin=accelZ[8]*8 + accelZ[8:]).int * (20.48*9.81/(2 ** 20))) #accelZ

            byte_rep = packet[22:23]
            data.append(struct.unpack("<B", byte_rep)[0]) #rssi

            #calculate packet loss
            if (last_packet != (data[2] - 1)) and (last_packet != -1) and (last_packet != (2^16 - 1)) and (data[2] - last_packet) > 0:
                packets_lost += data[2] - last_packet

            #write data to log
            write_line(data_log, data)

            #update gui
            last_packet = data[2]
            packet_loss_label.setText(str(packets_lost))
            rssi_label.setText(str(data[10]))
            baroLabel.setText(str(int(data[5]-launch_alt)))
            alt = data[5]
            data[5] -= launch_alt
            maxAltLabel.setText(str(int(data[6]-launch_alt)))
            velAccelLabel.setText(str(data[8]))
            machLabel.setText('%.2f' % (data[8]/1116.44))
            accelZLabel.setText('%.3f' % data[9])
            gyroZLabel.setText('%.3f' % data[7])
            latLabel.setText('%.6f' % data[3])
            longLabel.setText('%.6f' % data[4])
            status_byte_label.setText(data[1])

            #ranging
            try:
                if ranging:
                    r = haversine(lat, long, data[3], data[4])
                    range_label.setText(string(int(r)))
            except:
                print("Ranging failed!")

            #update database
            database = database.append(pd.DataFrame([data],columns=cols))

            #slice off out of range data
            database = database.tail(data_range)

            #update plots with new data
            for p in plots:
                p.updatePlot(database)

        #heart beat
        heart_beat_indicator.setText(beats[heart_beat % len(beats)])
        heart_beat += 1
    except:
        #heart beat
        heart_beat_indicator.setText(beats[heart_beat % len(beats)])
        heart_beat += 1
        return

#display window
#using .showMaximized() instead of .show() until I can figure out sizing
top.showMaximized()

#timer and tick updates
timer = QtCore.QTimer()
timer.timeout.connect(update)
timer.start(tick_rate)

#start application (Qt Loop Cycle)
app.exec_()

ser.close()
serial_log.close()
command_log.close()
data_log.close()
