nsternie/live_telemetry/(commit log)

2017-10-23 Adds kicad project skeleton
    [Flight_computer_LT.kicad_pcb, Flight_computer_LT.sch]
2017-10-23 Adds kicad library for project
2017-10-23 Adds STM32F446RET6 to lib
2017-10-29 Added W25N01GV
    Added 1 Gbit SPI flash chip (W25N01GV)
2017-10-29 Started schematic and added symbols
    Added STM32F446RE to schematic and added supporting passives. Added
    symbol for MS5607 barometer.
    [Flight_computer_LT.sch]
2017-10-30 Split sch into pages
    Split schematic into pages. Also added BMG250 gyro symbol to lib.
    [Microcontroller.sch, Sensors.sch]
2017-10-30 Added hiarchal sheets for various sensors
    [Accelerometer.sch, Acceleromter.sch, Barometer.sch, Connectors.sch, GyroArray.sch, Memory.sch, Microcontroller.sch]
2017-10-30 Deleted bad spelling
    [Acceleromter.sch]
2017-10-31 Added Radio Schematic
    Copied radio schematic from circuit maker. Cleaned up sch a bit by
    changing part symbols. Needs to be verified.
    [Accelerometer.sch, Barometer.sch, Connectors.sch, Flight_computer_LT.sch, GyroArray.sch, Memory.sch, Microcontroller.sch, Radio.sch]
2017-11-01 Added gyro array
    Added 6 BMG250s. Also deleted connector previously used for radio, which
    is now onboard.
    [Connectors.sch, GyroArray.sch]
2017-11-05 Added 2W PA and power stuff
    Added 2W PA and ldos to generate 5 and 3.3V power.
    [Accelerometer.sch, Barometer.sch, Connectors.sch, Flight_computer_LT.sch, GyroArray.sch, Memory.sch, Microcontroller.sch, Power.sch]
2017-11-07 Added GPS
    Added ublox gps schematic.
    [Connectors.sch, Flight_computer_LT.sch, GPS.sch, Memory.sch, Microcontroller.sch, Power.sch, Radio.sch, Sensors.sch]
2017-11-09 Updated connector page
    [Connectors.sch]
2017-11-10 Added uC connections
    Connected a bunch of stuff to uC. Pin list is on drive. Still WIP.
    Finished most footprints except accel, which Devin is working on.
    [Connectors.sch, Flight_computer_LT.sch, Memory.sch, Microcontroller.sch, Radio.sch, Sensors.sch]
2017-11-11 Added Kicad footprints library
2017-11-11 Footprint Associations
    [Connectors.sch, GPS.sch, Memory.sch, Microcontroller.sch, Power.sch, Radio.sch, Sensors.sch]
2017-11-12 Mid layout
    mid layout checkpoint. Still placing components. No wiring done.
    [_saved_Radio.sch]
2017-11-12 Component placement in progress
    [Connectors.sch, Flight_computer_LT.kicad_pcb, Radio.sch, _saved_Connectors.sch, _saved_Radio.sch]
2017-11-13 Has IMU code and other interface stuff
2017-11-14 Continuing layout
    Moved gyros and accel into actual positions.
    [Connectors.sch, Flight_computer_LT.kicad_pcb, _saved_Connectors.sch]
2017-11-15 Mid route
    Routing gyro area. Currently dumpster fire. From chaos comes order.
    [Flight_computer_LT.kicad_pcb, Sensors.sch]
2017-11-16 Routing
    Routing still in progress. Startting to look a little bit better.
    [Flight_computer_LT.kicad_pcb, Memory.sch, Microcontroller.sch, Sensors.sch]
2017-11-19 General Routing Done
    Routing done. Need to clean up everything and add testpoints.
    [Connectors.sch, Flight_computer_LT.kicad_pcb, Microcontroller.sch, Power.sch, Radio.sch]
2017-11-19 Tieing up loose ends
    Cleaning up board/sch and working on checklist.
    [Connectors.sch, Microcontroller.sch, _saved_GPS.sch, _saved_Radio.sch]
2017-11-19 Adding Test Points
    [Connectors.sch, Flight_computer_LT.kicad_pcb, GPS.sch, Microcontroller.sch, Sensors.sch, _saved_GPS.sch, _saved_Radio.sch]
2017-11-21 Cleaning
    Cleaning up sch and pcb.
    [Flight_computer_LT.kicad_pcb, GPS.sch, Microcontroller.sch, Power.sch, Radio.sch, Sensors.sch]
2017-12-29 Board changes
    [Connectors.sch, Flight_computer_LT.kicad_pcb, GPS.sch, Microcontroller.sch, Power.sch, Radio.sch, Sensors.sch]
2018-01-11 Flash files
    [Flash Header.xlsx]
2018-01-11 Flash things
    [Flash Header.xlsx]
2018-01-13 Whatever I worked on last night :)
    [Flash Header.xlsx]
2018-01-17 Flash stuff :)
    [Flash Header.xlsx]
2018-01-18 Added command stuff from the engine controller code base
    [Flash Header.xlsx]
2018-01-20 Sensor Changes
    Added code for accel and baro.
2018-01-20 initial commit of ground station gui
    [app_settings.csv, graph_settings.csv]
2018-01-27 Commandline works
    [Flash Header.xlsx]
2018-01-27 minumum viable product
    [graph_settings.csv]
2018-01-28 Im like Luigi, getting rod of those poltergiests
2018-01-28 numerical fields implemented
    [app_settings.csv, graph_settings.csv]
2018-01-28 command line input
    [graph_settings.csv]
2018-01-28 unnecessary print
2018-01-28 data logging
    [test_data_log_0.csv, test_data_log_1.csv, test_data_log_2.csv, test_data_log_3.csv]
2018-01-28 mach number
    [graph_settings.csv, test_data_log_0.csv]
2018-01-28 1, 2, 3, 4, 5. 1, 2, 3, 4, 5, 6, 7. This is a bad haiku.
    [Flash Header.xlsx, log.csv]
2018-01-28 com port selection
    [test_data_log_0.csv, test_data_log_1.csv, test_data_log_2.csv, test_data_log_3.csv]
2018-01-29 implemented status bar
    [test_data_log_0.csv]
2018-01-29 improved zero alt and status bar
    [test_data_log_0.csv, test_data_log_1.csv]
2018-01-29 Added log functions for some sensors
    [Flash Header.xlsx]
2018-01-29 Adds readfile funtions
    [Flash Header.xlsx]
2018-01-29 String format change
    [Flash Header.xlsx]
2018-01-30 Remove log files
    [log.csv]
2018-02-02 Added timers and dready interrupts for gyros and accel.
2018-02-09 Cleaned up old project files that were no longer being used to avoid confusion.
    [ADXL357.c, CC1125.c, CC1125.h, Flight_Computer_Core.ioc, Gen_Testing.ioc, _initialize_hardware.c, main.c]
2018-02-10 Added radio stuff. Fixed board_design folder.
    [Connectors.sch, Flight_computer_LT.kicad_pcb, Flight_computer_LT.sch, GPS.sch, Memory.sch, Microcontroller.sch, Power.sch, Radio.sch]
2018-02-10 Added project for ground station.
    [Flash Header.xlsx]
2018-02-17 Implemented tabs
    Added tabs to gui in preparation for maps
    [test_data_log_0.csv, test_data_log_1.csv]
2018-02-20 multiple new features
    command log tab
    command buttons
    applied new command standards
    time stamp to log box
    commands recieved counter
    [graph_settings.csv, test_data_log_0.csv, test_data_log_1.csv]
2018-02-20 Revert "updated baudrate and values in dummy"
    This reverts commit f9436dfd34327823331be304b8d484de9baaa7f1.
    [dummy.ino, gui.py]
2018-02-20 Revert "Revert "updated baudrate and values in dummy""
    This reverts commit 75b1cf553f4b4ca82790377cedd4be255a3a348a.
    [dummy.ino, gui.py]
2018-02-20 multiple new features
    - data logging directories
    - command line arguments to initialize run name
    - started on maps
    - command buttons improved
    - commands recieved fully implemented
    - auto scan on start
    [test_data_log_1.csv]
2018-03-06 Changed gyros to timer based and added delay on init, which seemed to fix init issues.
    [Flight_Computer_Core.ioc, main.c]
2018-03-07 Fixed radio packet len on transmitter
    [commandline.c, main.c, radio.c, radio.h]
2018-03-07 Put gyro delay back in
2018-03-07 gyro scaling
2018-03-07 hopefully fixed decimal point errors
    [gui.py]
2018-03-07 Changed GPS logging thing to fixed. Changed uart buad to 921600
    [Flight_Computer_Core.ioc, main.c]
2018-03-08 Added hex generation to ground station. Added RX_PARITY.
2018-03-08 Fixed [?] radio issue
    [main.c]
2018-03-08 Fixing gitignore
    [graph_settings.csv]
2018-03-08 Revert "Fixing gitignore"
    This reverts commit 1eaba9e6a756ccfc2ad3d51e16f2917715e98921.
    [graph_settings.csv]
2018-03-10 New PCB Rev, ready for verification
    [Connectors.sch, Flight_computer_LT.kicad_pcb, Flight_computer_LT.sch, GPS.sch, Memory.sch, Microcontroller.sch, Power.sch, Radio.sch]
2018-03-10 Board review notes
2018-03-17 Added projects for TX and RX
    [Connectors.sch, Flight_computer_LT.kicad_pcb, Radio.sch]
2018-03-18 Working on ground station
2018-03-19 Commands and receiver currently working. Moving on to FC TODO list
2018-03-29 Changed TX power to be safe with 2 amplifiers
2018-04-06 Added RSSI calculation and changed TX power on rocket side back to 13dbm. Also added a lockout for Baro.
2018-05-31 fix to max accel problem
    [sensors.c]
