nsternie/live_telemetry/(notices)

Notices in the files:
firmware/Atollic/Flight_Computer_Ground/Src/main.c:
(C) COPYRIGHT STMicroelectronics *****END OF FILE
